tgh-apil/airway_intubation_model/mandible_and_tongue_casting.md

## Mandible and tongue

The following instructions detail the process for casting the mandible and tongue, including both the healthy and pathological (tumor at base of tongue) variants. While the two variants require separate molds and different silicones, the steps for casting are the same.

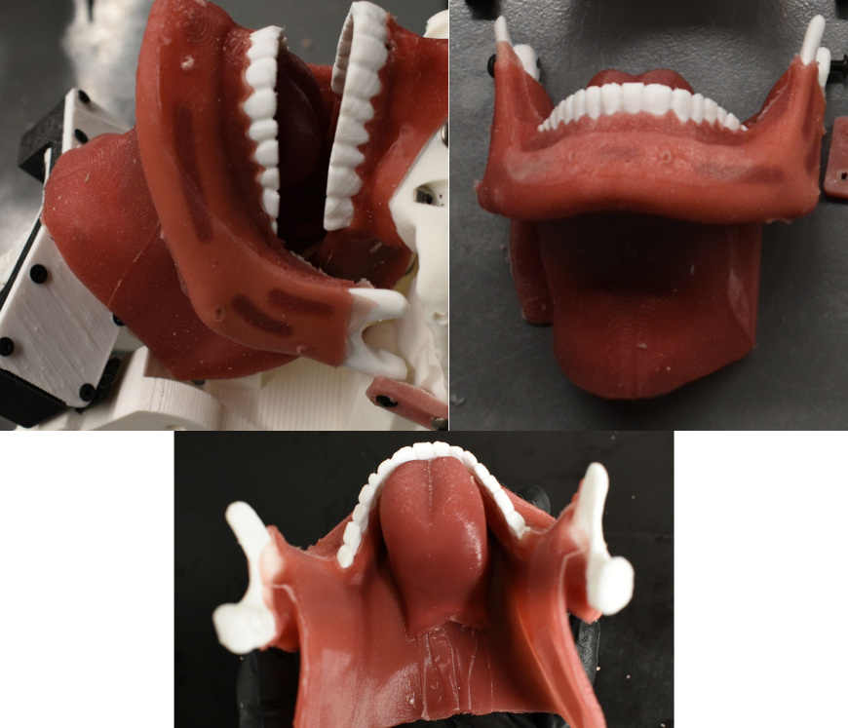
[picture p11: images/mandible_casting/0_mandible.png]


### Materials & equipment
#### Hardware
- 4 x 35mm M4 screws
- 2 x 25mm M4 screws
- 4 x 20mm M4 screws
- 4 x 18mm M4 screws
- 2 x 18mm M3 screws
- 6 x 14mm M3 screws
- Power drill or screwdriver

#### Printing
- Hard plastic filament (PLA, etc.)
- Fused Deposition Modelling 3D printer

#### Casting
- Two-part Platinum Cure Silicone Rubber
  - **Healthy anatomy:** Ecoflex 00-20: Available from [Smooth-On](https://www.smooth-on.com/products/ecoflex-00-20/)
  - **Pathological anatomy (tumor):** Ecoflex 00-30: Available from [Smooth-On](https://www.smooth-on.com/products/ecoflex-00-30/)
- Silc Pig silicone pigments in blood: Available from [Smooth-On](https://www.smooth-on.com/products/silc-pig/)
- Mold release agent: Available from [Smooth-On](https://www.smooth-on.com/product-line/universal-mold-release/)
- Hot glue gun
- Mesh stretch fabric (nylon, polyester, etc.)

#### Components
Anatomy/casting components:
- mandible ([mandible.stl](https://github.com/tgh-apil/airway_intubation_model/blob/main/stl_files/mandible_and_tongue_casting/mandible.stl))
- epiglottis casting plate ([epiglottis_plate.stl](https://github.com/tgh-apil/airway_intubation_model/blob/main/stl_files/mandible_and_tongue_casting/epiglottis_plate.stl))

Healthy mold components:
- back ([mandible_mold_back.stl](https://github.com/tgh-apil/airway_intubation_model/blob/main/stl_files/mandible_and_tongue_casting/healthy_anatomy_mold/mandible_mold_back.stl))
- bottom ([mandible_mold_bottom.stl](https://github.com/tgh-apil/airway_intubation_model/blob/main/stl_files/mandible_and_tongue_casting/healthy_anatomy_mold/mandible_mold_bottom.stl))
- front left ([mandible_mold_front_L.stl](https://github.com/tgh-apil/airway_intubation_model/blob/main/stl_files/mandible_and_tongue_casting/healthy_anatomy_mold/mandible_mold_front_L.stl))
- front right ([mandible_mold_front_R.stl](https://github.com/tgh-apil/airway_intubation_model/blob/main/stl_files/mandible_and_tongue_casting/healthy_anatomy_mold/mandible_mold_front_R.stl))
- side left ([mandible_mold_side_L.stl](https://github.com/tgh-apil/airway_intubation_model/blob/main/stl_files/mandible_and_tongue_casting/healthy_anatomy_mold/mandible_mold_side_L.stl))
- side right ([mandible_mold_side_R.stl](https://github.com/tgh-apil/airway_intubation_model/blob/main/stl_files/mandible_and_tongue_casting/healthy_anatomy_mold/mandible_mold_side_R.stl))
- top ([mandible_mold_top.stl](https://github.com/tgh-apil/airway_intubation_model/blob/main/stl_files/mandible_and_tongue_casting/healthy_anatomy_mold/mandible_mold_top.stl))

Pathological mold components:
- back ([mandible_mold_back_tumor.stl](https://github.com/tgh-apil/airway_intubation_model/blob/main/stl_files/mandible_and_tongue_casting/pathological_anatomy_mold/mandible_mold_back_tumor.stl))
- bottom ([mandible_mold_bottom_tumor.stl](https://github.com/tgh-apil/airway_intubation_model/blob/main/stl_files/mandible_and_tongue_casting/pathological_anatomy_mold/mandible_mold_bottom_tumor.stl))
- front left ([mandible_mold_front_L_tumor.stl](https://github.com/tgh-apil/airway_intubation_model/blob/main/stl_files/mandible_and_tongue_casting/pathological_anatomy_mold/mandible_mold_front_L_tumor.stl))
- front right ([mandible_mold_front_R_tumor.stl](https://github.com/tgh-apil/airway_intubation_model/blob/main/stl_files/mandible_and_tongue_casting/pathological_anatomy_mold/mandible_mold_front_R_tumor.stl))
- side left ([mandible_mold_side_L_tumor.stl](https://github.com/tgh-apil/airway_intubation_model/blob/main/stl_files/mandible_and_tongue_casting/pathological_anatomy_mold/mandible_mold_side_L_tumor.stl))
- side right ([mandible_mold_side_R_tumor.stl](https://github.com/tgh-apil/airway_intubation_model/blob/main/stl_files/mandible_and_tongue_casting/pathological_anatomy_mold/mandible_mold_side_R_tumor.stl))
- top ([mandible_mold_top_tumor.stl](https://github.com/tgh-apil/airway_intubation_model/blob/main/stl_files/mandible_and_tongue_casting/pathological_anatomy_mold/mandible_mold_top_tumor.stl))

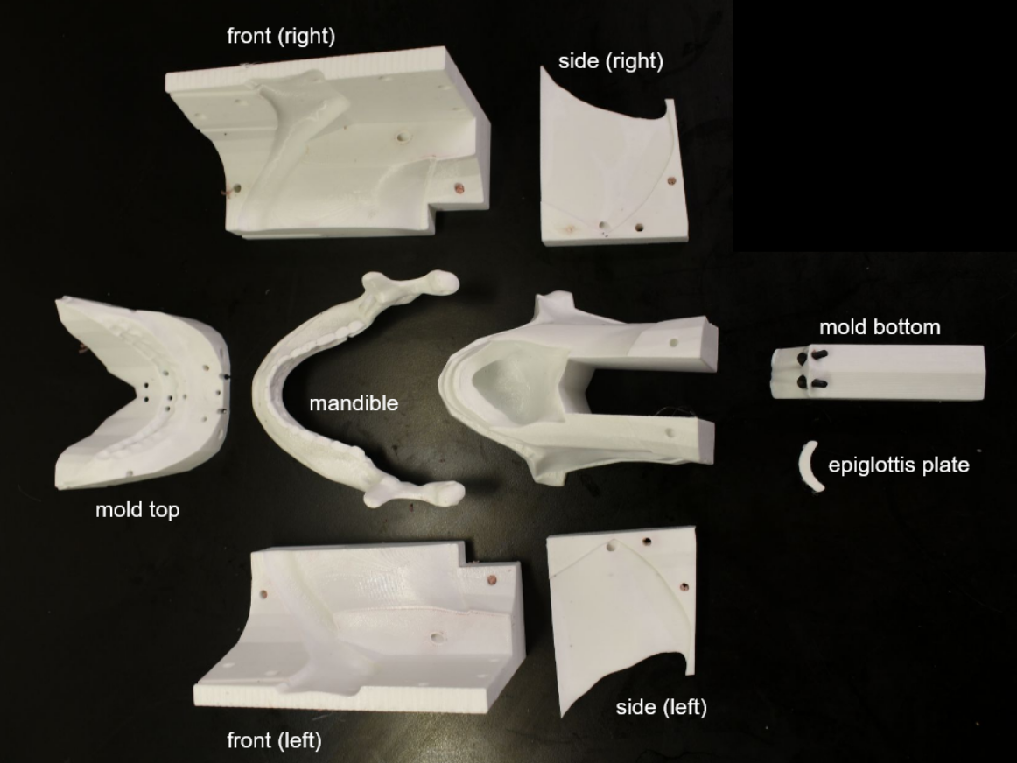
[picture p12: images/mandible_casting/1_mandible.png]


### Instructions
1. Print the components listed above for the desired variant (the healthy variant is shown in the images below).
2. Apply mold release agent to the mold components. Do not apply it to the mandible or epiglottis casting plate, as the silicone is not intended to be removed from these components.
3. Optionally, cut out a small rectangle of mesh fabric large enough to cover the epiglottis plate—about 2cm x 4cm. Overlay it on top of the plate and use a marker to mark the location of the holes for the screws, then make small cuts in the fabric at these locations to ease the screw insertion process later. (Note: The mesh is not strictly necessary, but improves the longevity of the cast piece by preventing the epiglottis plate from tearing out of the silicone.)
4. Per the image below, align the epiglottis plate about 0.5cm above the bottom mold component so that the holes in the plate are aligned with those of the bottom mold component, and the concave side of the plate faces the convex side of the bottom mold component. Use two 14mm M3 screws to attach the two while maintaining the ~0.5cm gap. If using the mesh fabric, pass the screws through it as well and insert it between the epiglottis plate and the mold component.

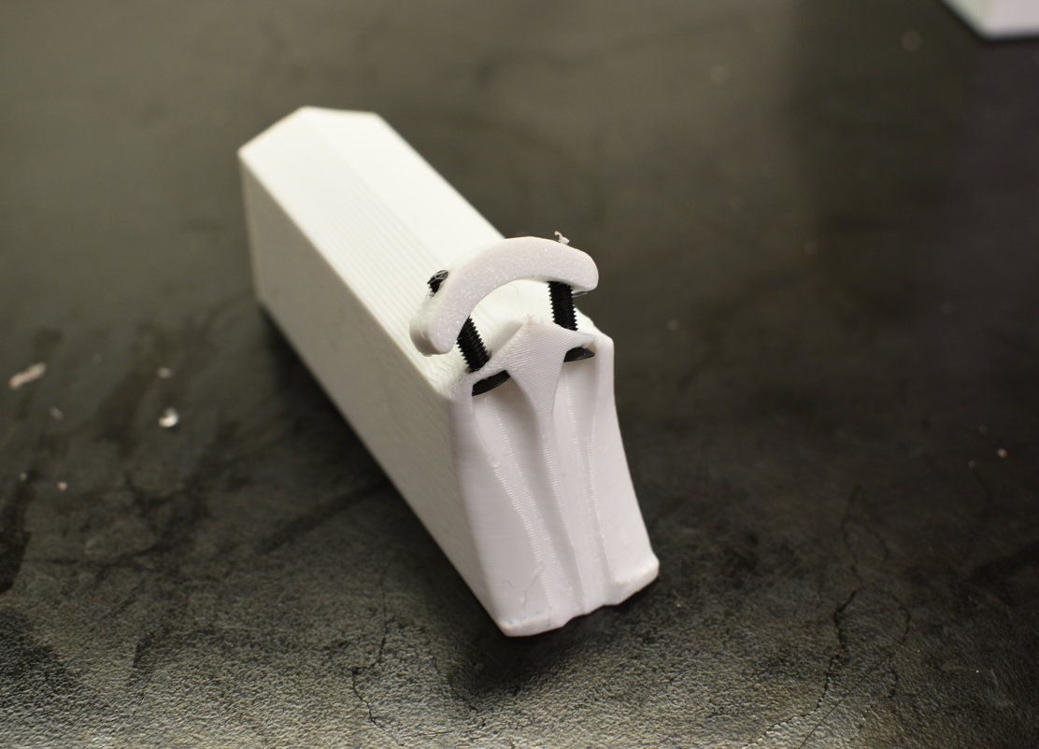
[picture p13: images/mandible_casting/2_mandible.png]


5. Assemble the rest of the mold.
    1. Align the body and ramus of the mandible with the groove in one side of the outer mold and attach the two with two 14mm M3 screws. Do the same with the other side of the outer mold.

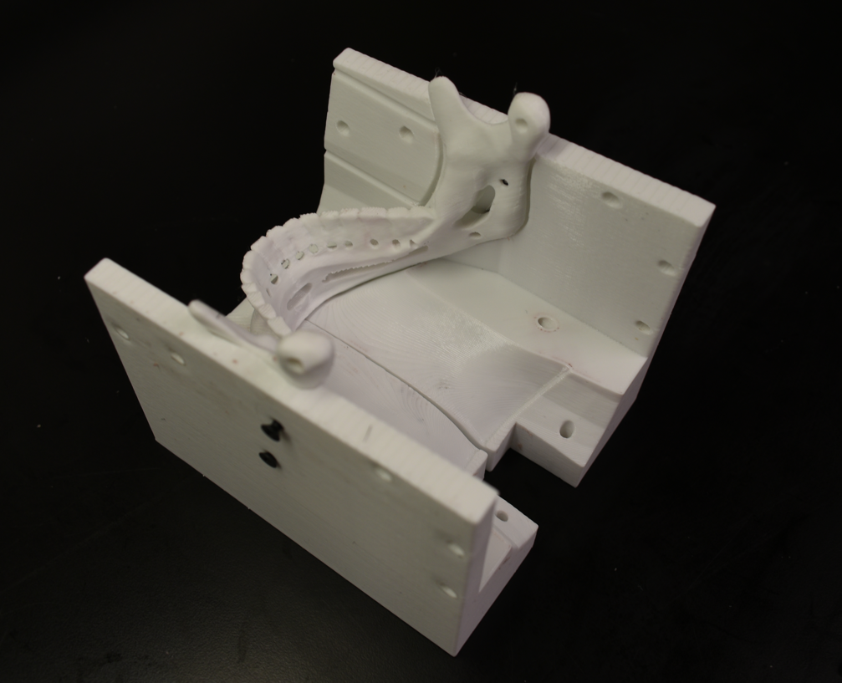
[picture p14: images/mandible_casting/3_mandible.png]
       
    2. Attach the two side mold components with one 18mm M4 screw each in the following hole (see image). The side components will later also be attached to the back mold component with two 35mm M4s.

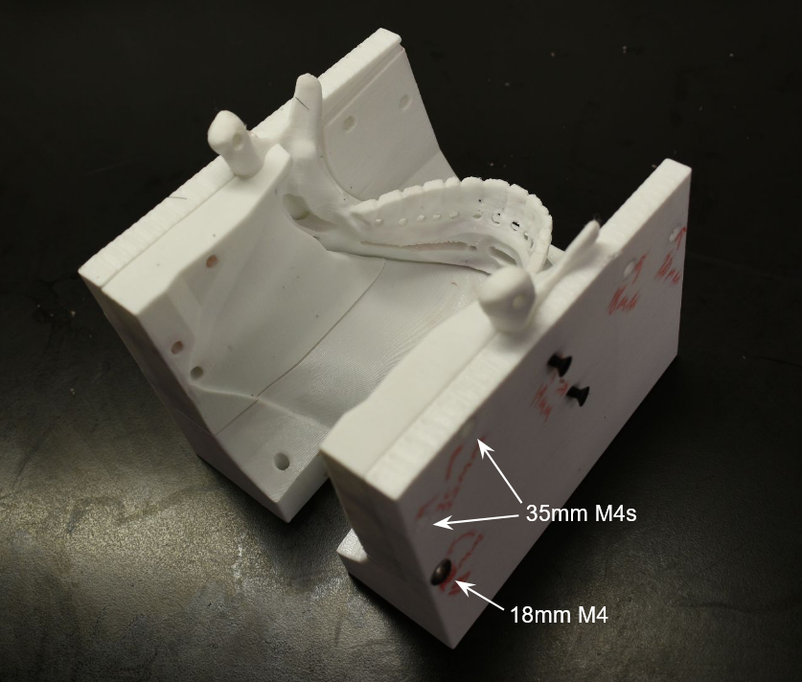
[picture p15: images/mandible_casting/4_mandible.png]
       
    3. Slide the bottom component (with epiglottis plate attached) into the slot in the back component so the curved portions at the fronts of the components lie flush.

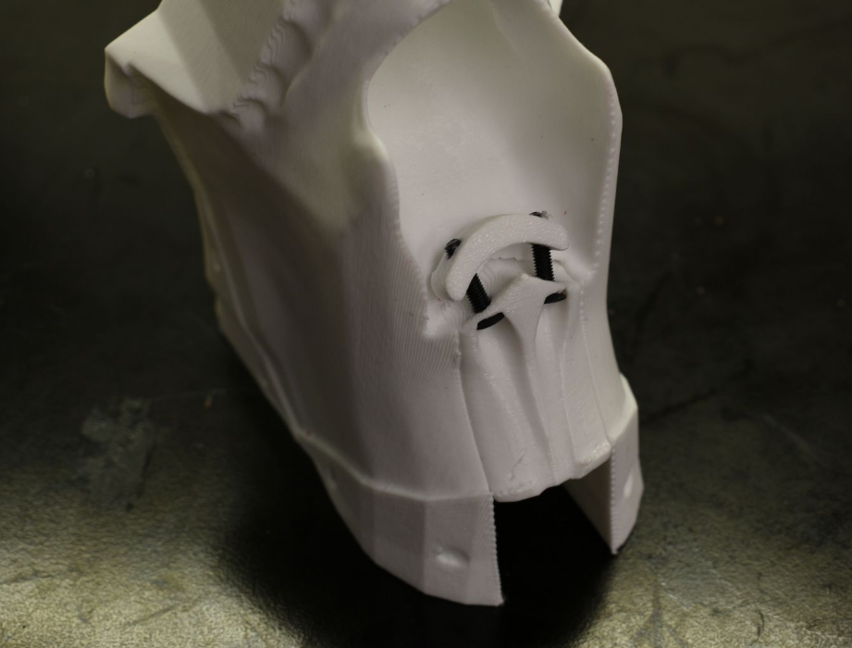
[picture p16: images/mandible_casting/5_mandible.png]
       
    4. Attach the back component to the rest of the mold with four 35mm M4 screws (the ones that also pass through the side mold components), and two 18mm M4 screws.
    5. Attach the top mold component with two 25mm M4 screws and four 20mm M4 screws, then with two 18mm M3 screws to attach it to the mandible inside.

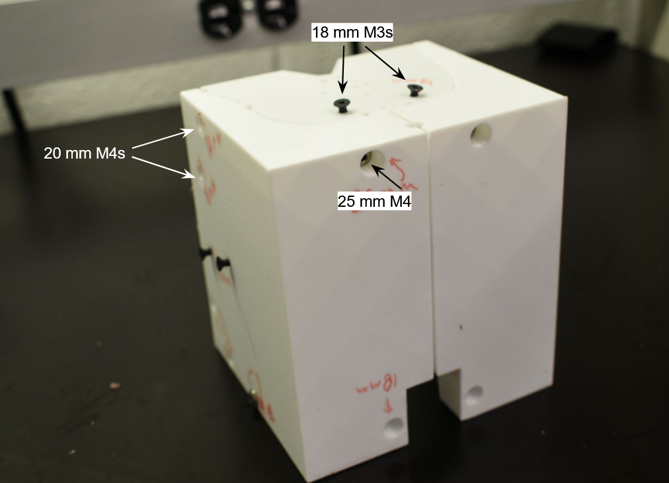
[picture p17: images/mandible_casting/6_mandible.png]


6. Use a hot glue gun to seal the seams of the mold to prevent silicone from leaking during the casting process. Small pieces of paper towel may be crumpled into the deeper screw holes first to make the removal of the glue easier later on.

7. Mix 200 mL of Ecoflex 00-20 for the healthy variant, or 200 mL of Ecoflex 00-30 for the pathological variant, dyed with Silc Pig pigment in the colour Blood. Inject into mold using the largest vent hole.

8. Once cured, remove the hot glue and unscrew the mold components. Remove the mold components, cutting the vent hole paths as you go, until you are left with the back and bottom components. Before removing the silicone from these, you will need to unscrew the two 14mm M3s attached to the epiglottis plate which has now been embedded in the silicone. 

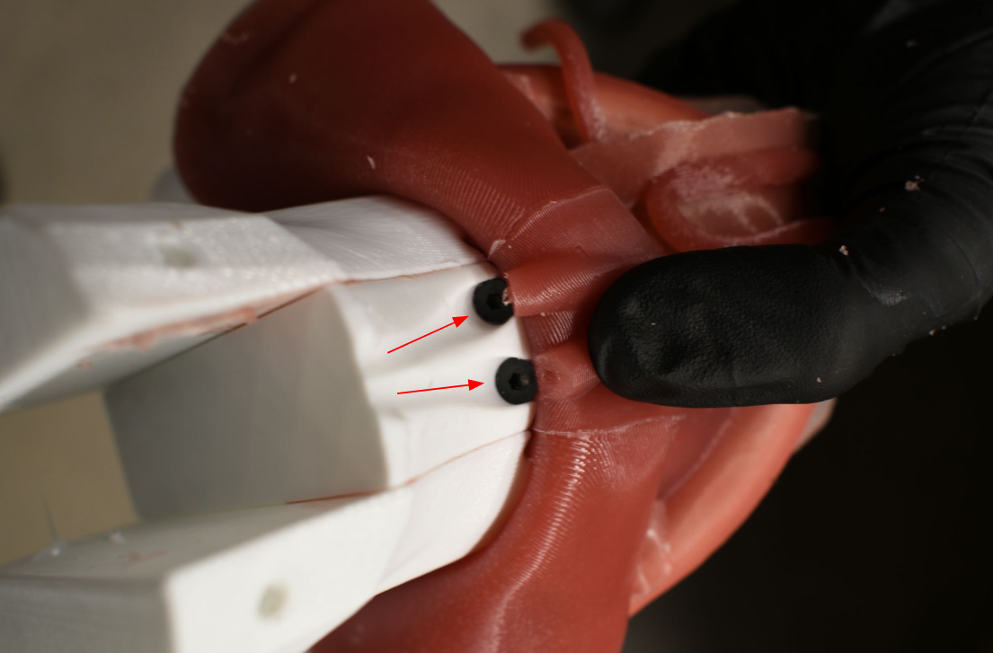
[picture p18: images/mandible_casting/7_mandible.png]


9. Once the silicone has been fully removed from the mold, trim any flashing and cut away the excess silicone on the teeth to reveal them.
