tgh-apil/airway_intubation_model/pharynx_casting.md

## Pharynx

The following instructions detail the process for casting the silicone component comprising the roof of mouth and back of throat.

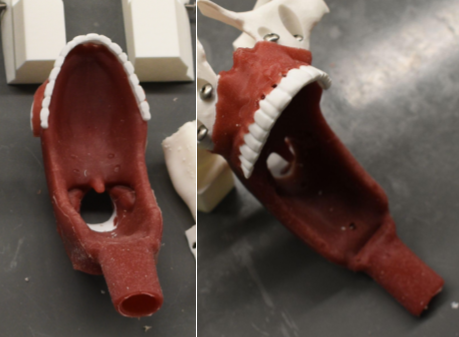
[picture p22: images/pharynx_casting/pharynx_cast.png]


### Materials & equipment
#### Hardware
- 46 x 10mm M4 screws
- 2 x 18mm M4 screws
- 2 x 20mm M4 screws
- Power drill or screwdriver

#### Printing
- Hard plastic filament (PLA, etc.)
- Fused Deposition Modelling 3D printer

#### Casting
- Two-part Platinum Cure Silicone Rubber
  - Ecoflex 00-30: Available from [Smooth-On](https://www.smooth-on.com/products/ecoflex-00-30/)
- Silc Pig silicone pigments in blood: Available from [Smooth-On](https://www.smooth-on.com/products/silc-pig/)
- Mold release agent: Available from [Smooth-On](https://www.smooth-on.com/product-line/universal-mold-release/)
- Hot glue gun

#### Components
Anatomy:
- pharynx: ([upper_jaw_pharynx.stl](https://github.com/tgh-apil/airway_intubation_model/blob/main/stl_files/pharynx_casting/upper_jaw_pharynx.stl))

Mold components:
- back lower left ([pharynx_mold_back_lower_L.stl](https://github.com/tgh-apil/airway_intubation_model/blob/main/stl_files/pharynx_casting/pharynx_mold/pharynx_mold_back_lower_L.stl))
- back lower right ([pharynx_mold_back_lower_R.stl](https://github.com/tgh-apil/airway_intubation_model/blob/main/stl_files/pharynx_casting/pharynx_mold/pharynx_mold_back_lower_R.stl))
- back upper left part A ([pharynx_mold_back_upper_La.stl](https://github.com/tgh-apil/airway_intubation_model/blob/main/stl_files/pharynx_casting/pharynx_mold/pharynx_mold_back_upper_La.stl))
- back upper left part B ([pharynx_mold_back_upper_Lb.stl](https://github.com/tgh-apil/airway_intubation_model/blob/main/stl_files/pharynx_casting/pharynx_mold/pharynx_mold_back_upper_Lb.stl))
- back upper right part A ([pharynx_mold_back_upper_Ra.stl](https://github.com/tgh-apil/airway_intubation_model/blob/main/stl_files/pharynx_casting/pharynx_mold/pharynx_mold_back_upper_Ra.stl))
- back upper right part B ([pharynx_mold_back_upper_Rb.stl](https://github.com/tgh-apil/airway_intubation_model/blob/main/stl_files/pharynx_casting/pharynx_mold/pharynx_mold_back_upper_Rb.stl))
- esophagus inner ([pharynx_mold_esophagus_inner.stl](https://github.com/tgh-apil/airway_intubation_model/blob/main/stl_files/pharynx_casting/pharynx_mold/pharynx_mold_esophagus_inner.stl))
- esophagus left ([pharynx_mold_esophagus_L.stl](https://github.com/tgh-apil/airway_intubation_model/blob/main/stl_files/pharynx_casting/pharynx_mold/pharynx_mold_esophagus_L.stl))
- esophagus right ([pharynx_mold_esophagus_R.stl](https://github.com/tgh-apil/airway_intubation_model/blob/main/stl_files/pharynx_casting/pharynx_mold/pharynx_mold_esophagus_R.stl))
- lower front ([pharynx_mold_front_lower.stl](https://github.com/tgh-apil/airway_intubation_model/blob/main/stl_files/pharynx_casting/pharynx_mold/pharynx_mold_front_lower.stl))
- upper front ([pharynx_mold_front_upper.stl](https://github.com/tgh-apil/airway_intubation_model/blob/main/stl_files/pharynx_casting/pharynx_mold/pharynx_mold_front_upper.stl))
- connector plates: ([\pharynx_casting\pharynx_mold\connector plates](https://github.com/tgh-apil/airway_intubation_model/tree/main/stl_files/pharynx_casting/pharynx_mold/connector%20plates))

### Instructions
1. Print the components listed above in hard plastic filament.
2. Apply mold release agent to the mold components. Do not apply it to the pharynx, as the silicone is not intended to be removed from this component. It is also not necessary to apply it to the connector plates as they do not come into direct contact with the silicone.
3. Assemble the mold. (It is recommended to begin with one side; these instructions begin with the left for the sake of clarity, but beginning with the right is equally feasible.)
    1. Slot the back lower left component into the pharynx and attach together with an 18mm M4 screw.

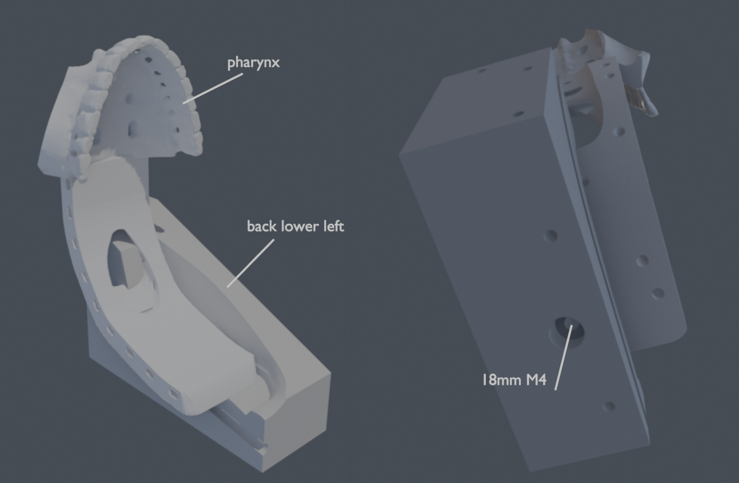
[picture p23: images/pharynx_casting/1_pharynx.png]
       
    2. Slot the back upper left part A component into the pharynx and attach together with a 20mm M4 screw.

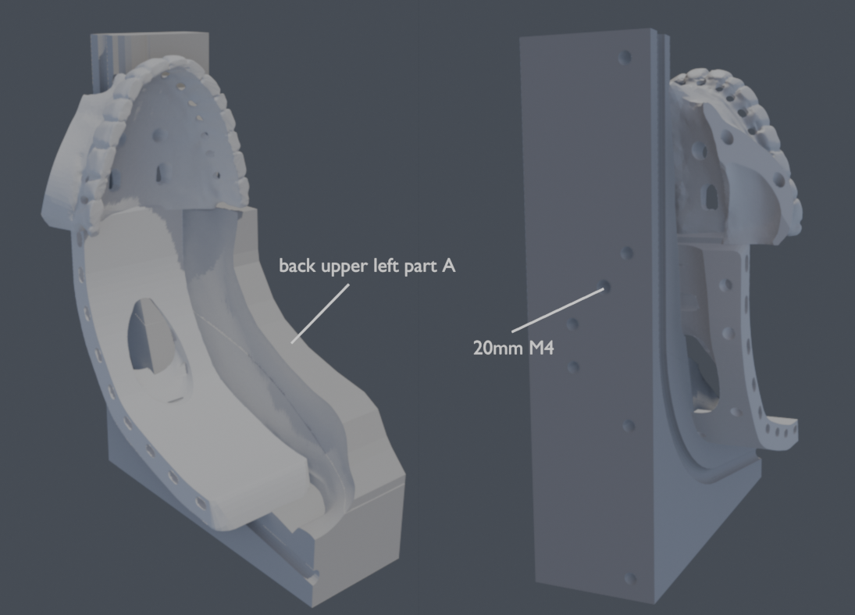
[picture p24: images/pharynx_casting/2_pharynx.png]
       
    3. Secure the back left components with the left connector plate and four 10mm M4s.

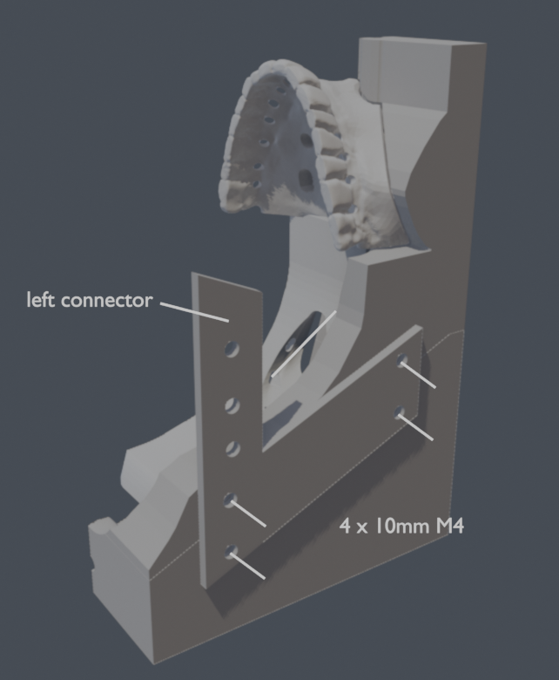
[picture p25: images/pharynx_casting/3_pharynx.png]
       
    4. Repeat the above steps with the right side of the back lower and upper components, and the right connector plate.
    5. Insert the upper front component, then the lower front component. Attach to mold with the left and right connector plates and six 10mm M4s.

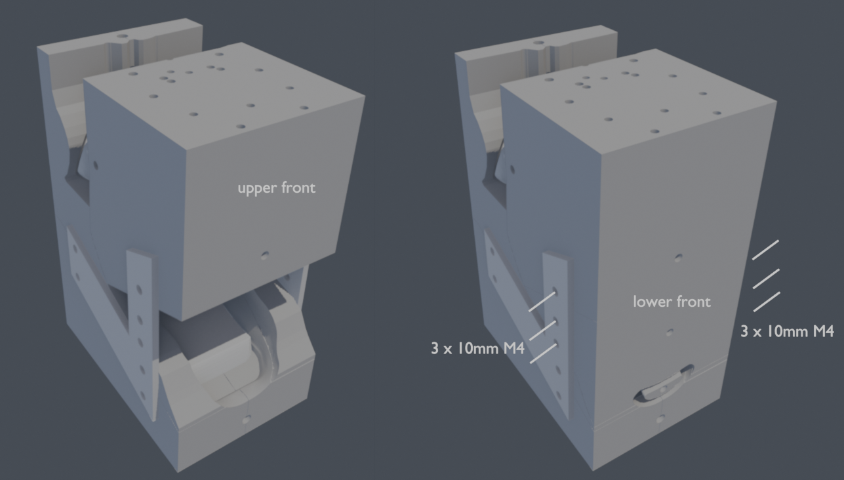
[picture p26: images/pharynx_casting/5_pharynx.png]
       
    6. Insert the back upper left and right part B components.
    7. Assemble the three esophagus components (left, right, and inner) and attach to the main mold with the front and back lower connector plates and sixteen 10mm M4s.
       
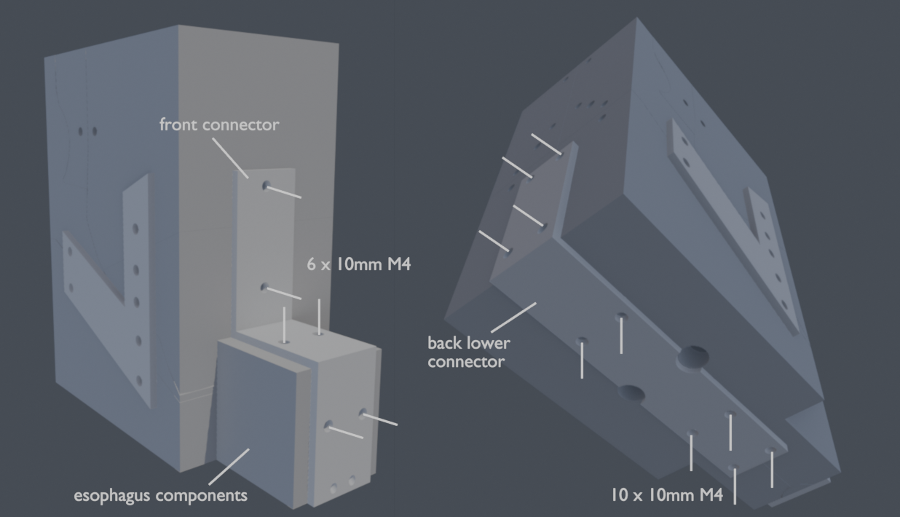
[picture p27: images/pharynx_casting/7_pharynx.png]
       
    8. Secure the remainder of the mold with the remaining connector plates (back, back upper, and top) and sixteen 10mm M4s.

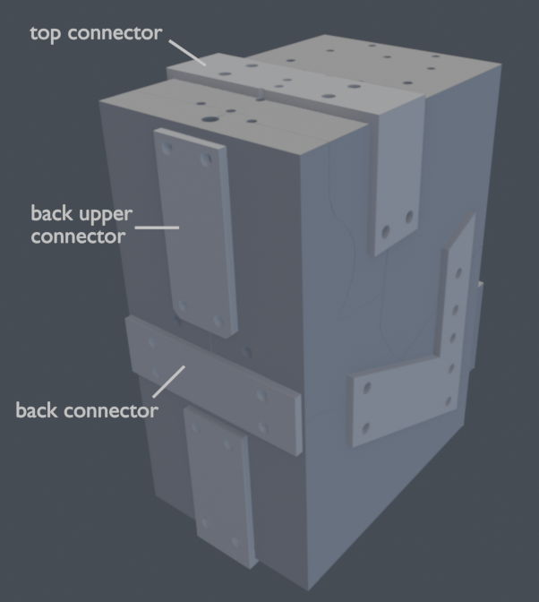
[picture p28: images/pharynx_casting/8_pharynx.png]
       
4. Use a hot glue gun to seal the seams of the mold to prevent silicone from leaking during the casting process.
5. Mix 300 mL of Ecoflex 00-30, dyed with Silc Pig blood pigment. Inject into mold using the largest vent hole.
6. Once cured, disassemble the mold in reverse order of assembly. Trim any flashing and cut out the teeth and airway.
