tgh-apil/airway_intubation_model/images/mandible_casting/8_mandible.png

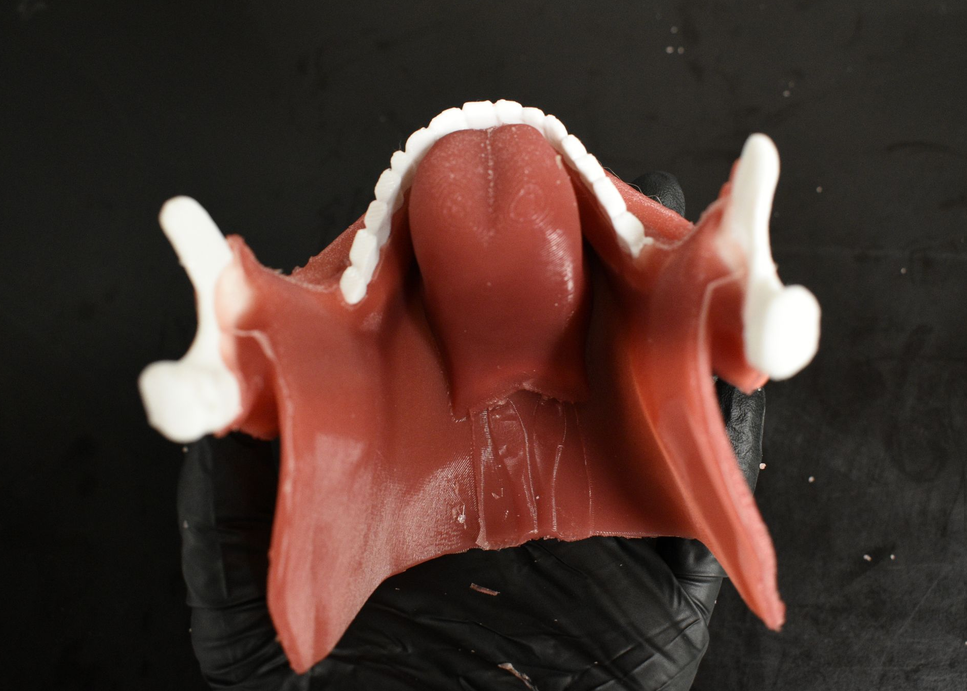
images/mandible_casting/8_mandible.png
