tgh-apil/airway_intubation_model/images/pharynx_casting/4_pharynx.png

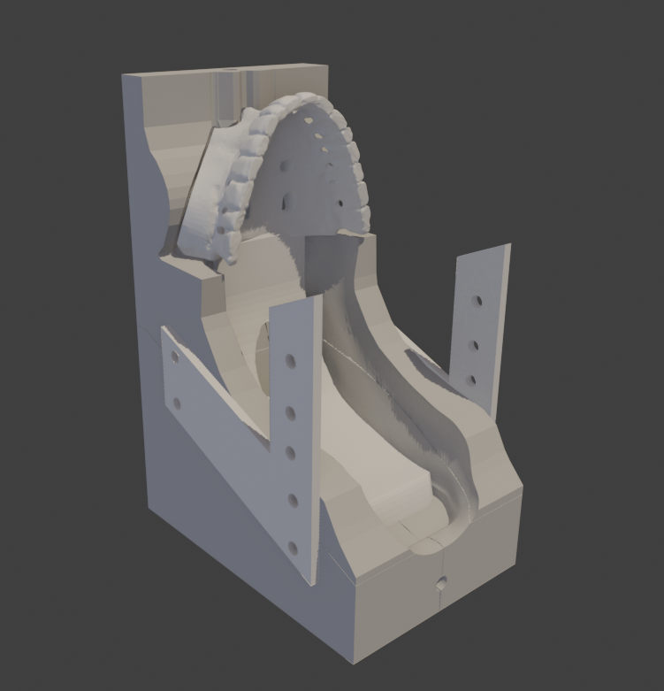
images/pharynx_casting/4_pharynx.png
