tgh-apil/airway_intubation_model/images/pharynx_casting/6_pharynx.png

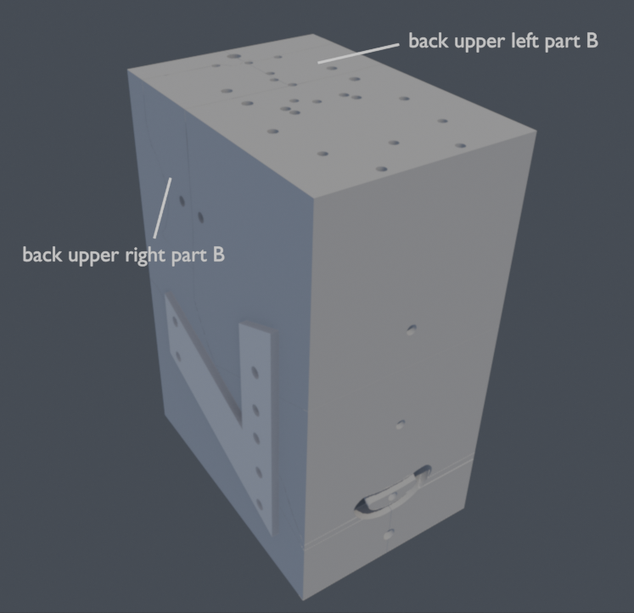
images/pharynx_casting/6_pharynx.png
