tgh-apil/airway_intubation_model/images/model_assembly_instructions/0_intubation_model_components.png

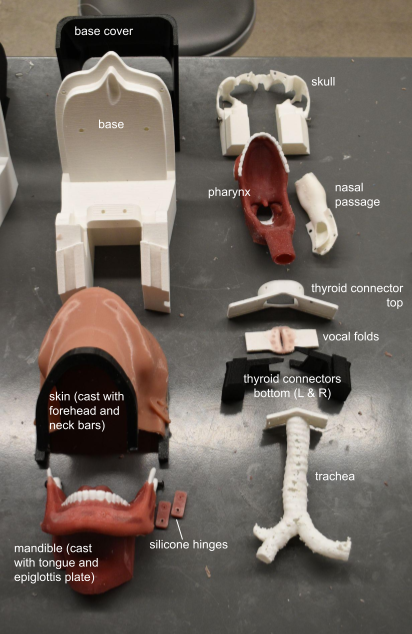
images/model_assembly_instructions/0_intubation_model_components.png
