tgh-apil/airway_intubation_model/stl_files/base/skull.stl

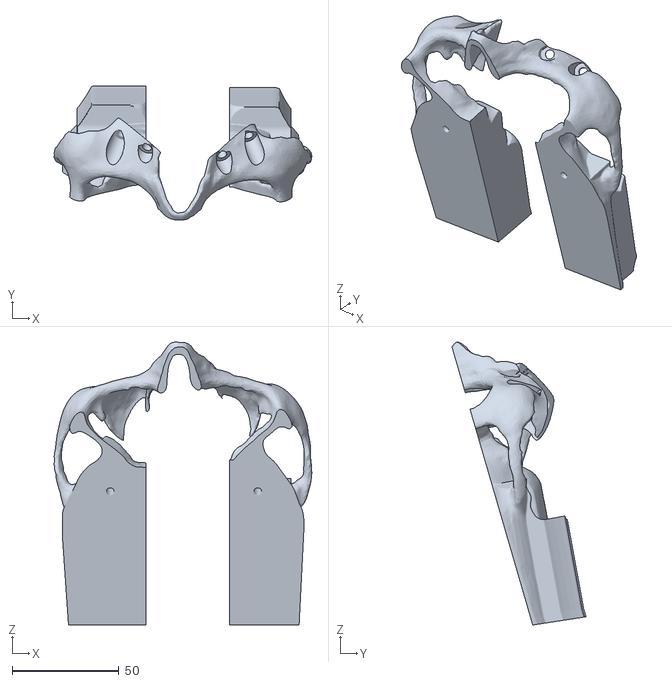
[picture p37: CAD file, 2026-10-07]
stl_files/base/skull.stl
120.5 x 62.7 x 132.3
