tgh-apil/airway_intubation_model/stl_files/mandible_and_tongue_casting/healthy_anatomy_mold/mandible_mold_bottom.stl

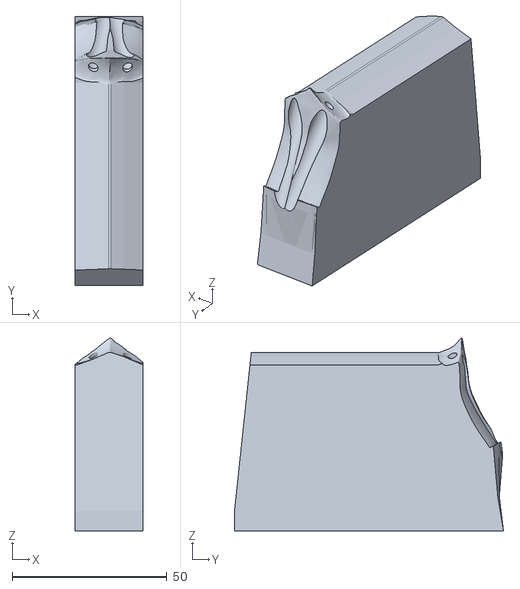
[picture p38: CAD file, 2026-10-06]
stl_files/mandible_and_tongue_casting/healthy_anatomy_mold/mandible_mold_bottom.stl
22.1 x 87.0 x 62.3
