tgh-apil/airway_intubation_model/stl_files/mandible_and_tongue_casting/mandible.stl

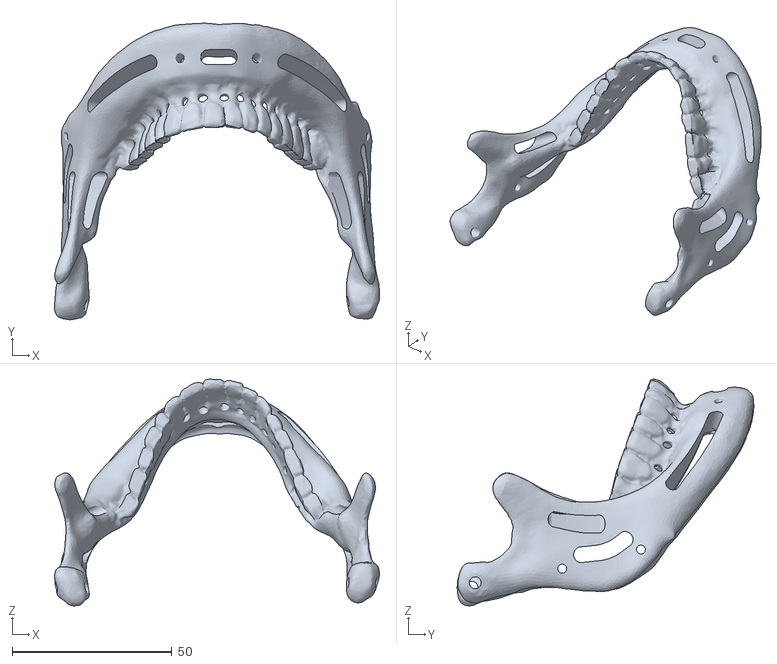
[picture p39: CAD file, 2026-10-06]
stl_files/mandible_and_tongue_casting/mandible.stl
101.6 x 92.7 x 70.9
