tgh-apil/airway_intubation_model/stl_files/mandible_and_tongue_casting/pathological_anatomy_mold/mandible_mold_front_L_tumor.stl

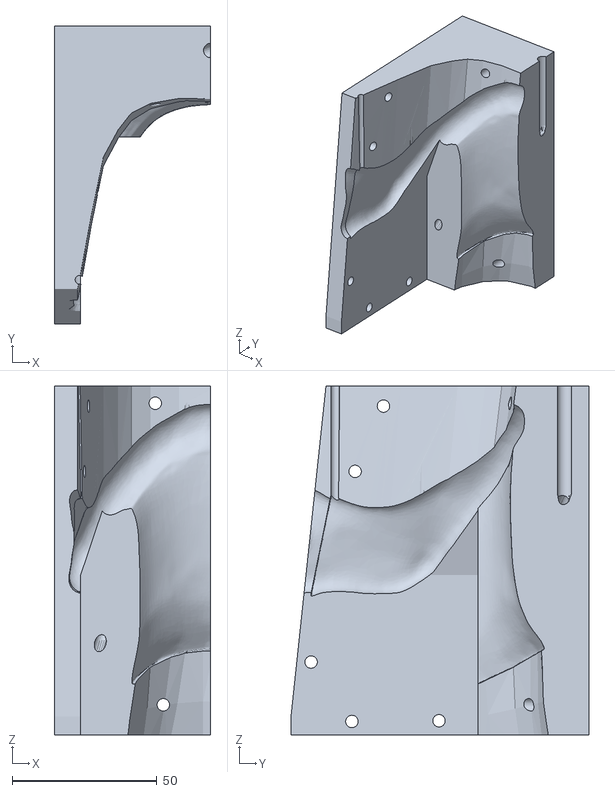
[picture p40: CAD file, 2026-10-06]
stl_files/mandible_and_tongue_casting/pathological_anatomy_mold/mandible_mold_front_L_tumor.stl
54.1 x 103.0 x 120.6
