tgh-apil/airway_intubation_model/stl_files/nasal_passage.stl

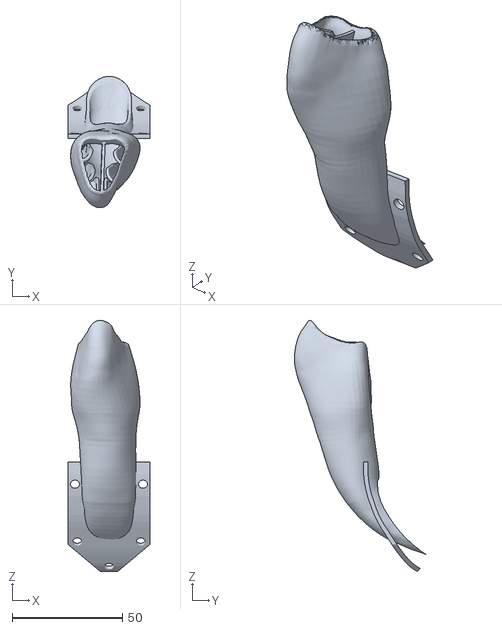
[picture p41: CAD file, 2026-10-07]
stl_files/nasal_passage.stl
37.1 x 59.5 x 113.7
