tgh-apil/airway_intubation_model/stl_files/pharynx_casting/pharynx_mold/connector plates/pharynx_mold_connector_top.stl

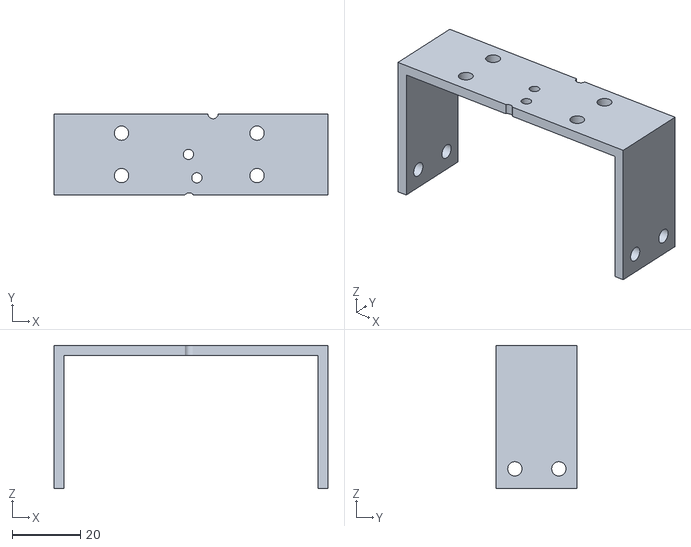
[picture p42: CAD file, 2026-09-28]
stl_files/pharynx_casting/pharynx_mold/connector plates/pharynx_mold_connector_top.stl
80.3 x 23.6 x 42.0
