tgh-apil/airway_intubation_model/stl_files/pharynx_casting/pharynx_mold/pharynx_mold_back_upper_Lb.stl

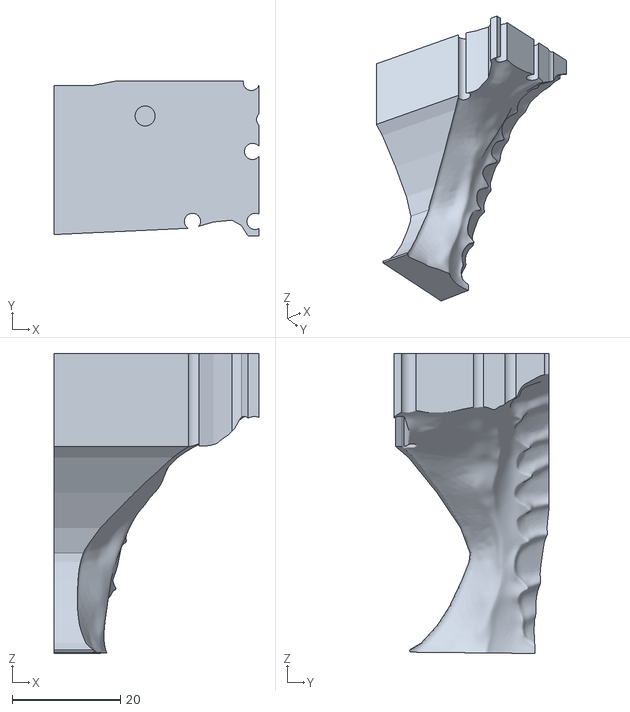
[picture p43: CAD file, 2026-09-28]
stl_files/pharynx_casting/pharynx_mold/pharynx_mold_back_upper_Lb.stl
37.8 x 28.7 x 55.4
