tgh-apil/airway_intubation_model/stl_files/pharynx_casting/upper_jaw_pharynx.stl

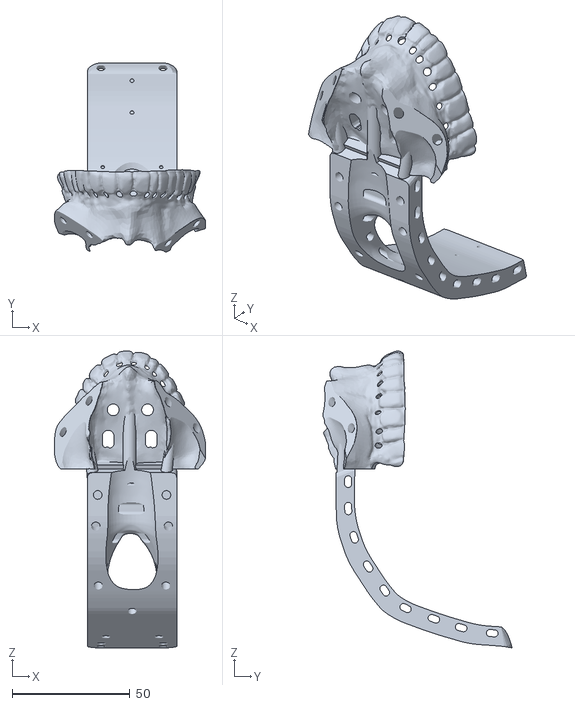
[picture p44: CAD file, 2026-09-28]
stl_files/pharynx_casting/upper_jaw_pharynx.stl
64.4 x 80.5 x 126.2
