tgh-apil/airway_intubation_model/stl_files/skin_casting/skin_mold/skin_mold_bottom.stl

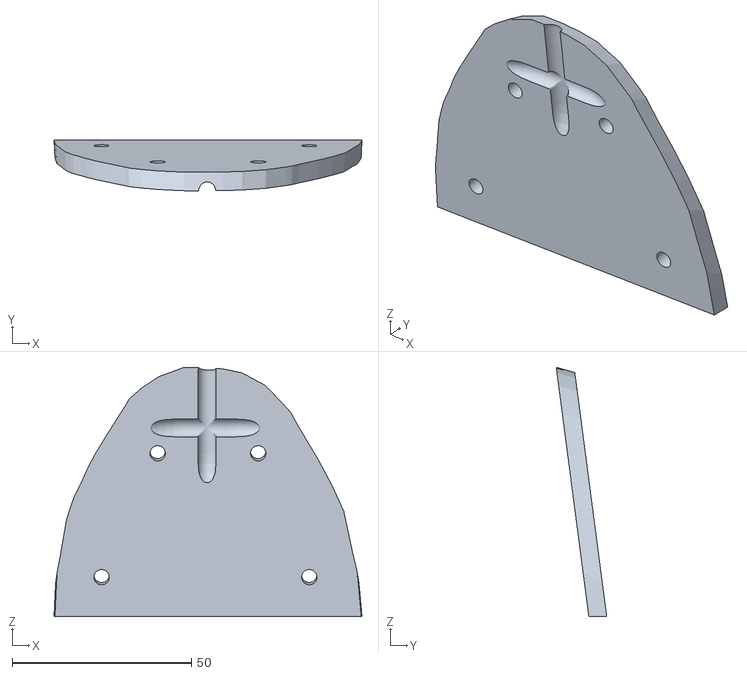
[picture p45: CAD file, 2026-09-29]
stl_files/skin_casting/skin_mold/skin_mold_bottom.stl
86.0 x 14.1 x 69.6
