tgh-apil/airway_intubation_model/stl_files/skin_casting/skin_neck_bar.stl

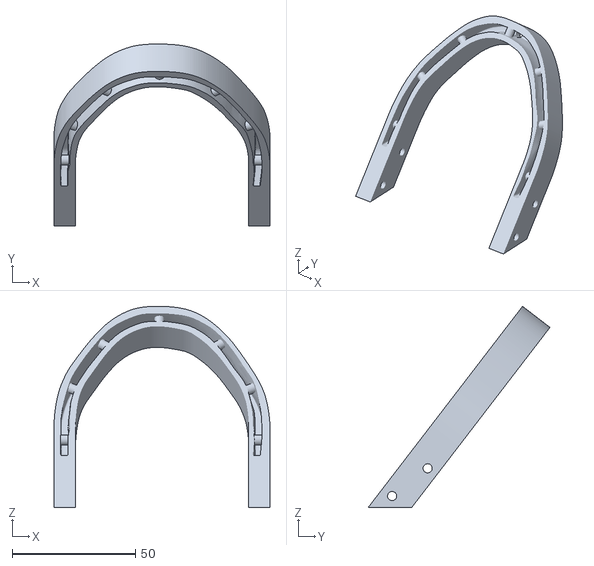
[picture p46: CAD file, 2026-09-29]
stl_files/skin_casting/skin_neck_bar.stl
87.5 x 73.7 x 81.5
