tgh-apil/airway_intubation_model/stl_files/thyroid_cartilage_and_connector/thyroid_connector_bottom_L.stl

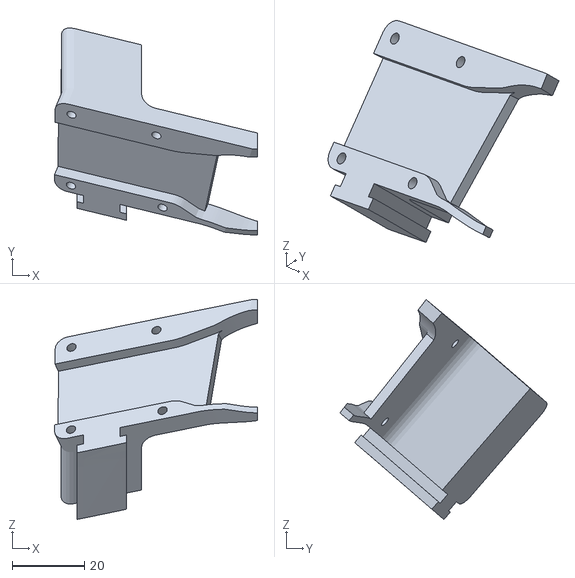
[picture p47: CAD file, 2026-10-07]
stl_files/thyroid_cartilage_and_connector/thyroid_connector_bottom_L.stl
56.0 x 57.1 x 60.7
