tgh-apil/airway_intubation_model/stl_files/trachea/pathological/trach_tumor_holder_2.stl

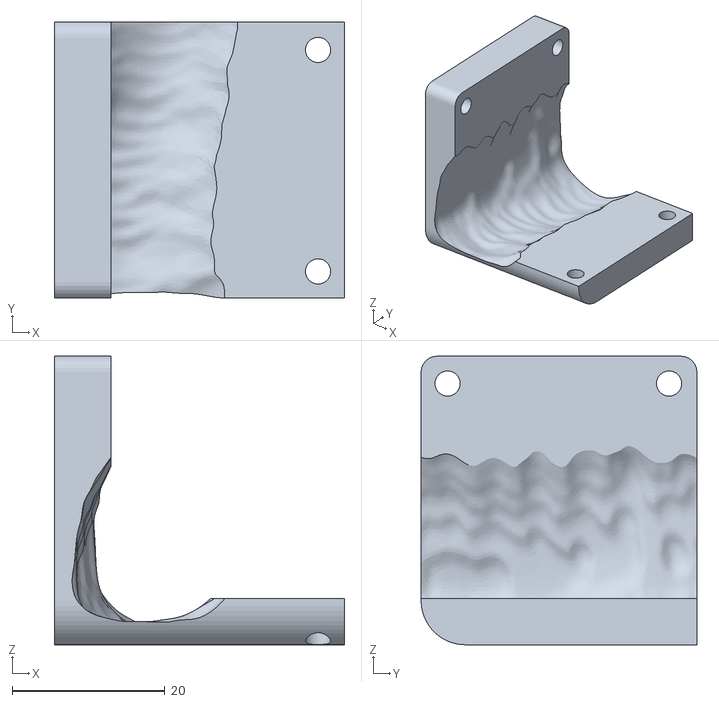
[picture p48: CAD file, 2026-09-21]
stl_files/trachea/pathological/trach_tumor_holder_2.stl
38.0 x 36.2 x 37.8
