tgh-apil/airway_intubation_model/stl_files/trachea/trachea_healthy_v3.stl

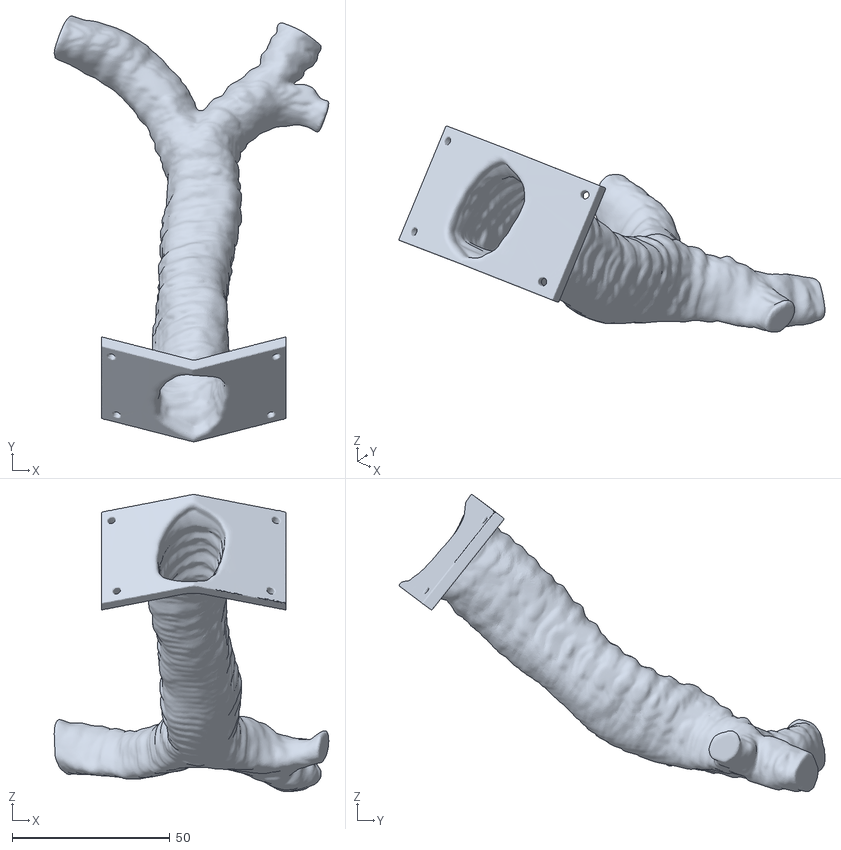
[picture p49: CAD file, 2026-09-21]
stl_files/trachea/trachea_healthy_v3.stl
86.9 x 134.8 x 94.2
