tgh-apil/airway_intubation_model/stl_files/vocal_folds/vocal_fold_wing_R.stl

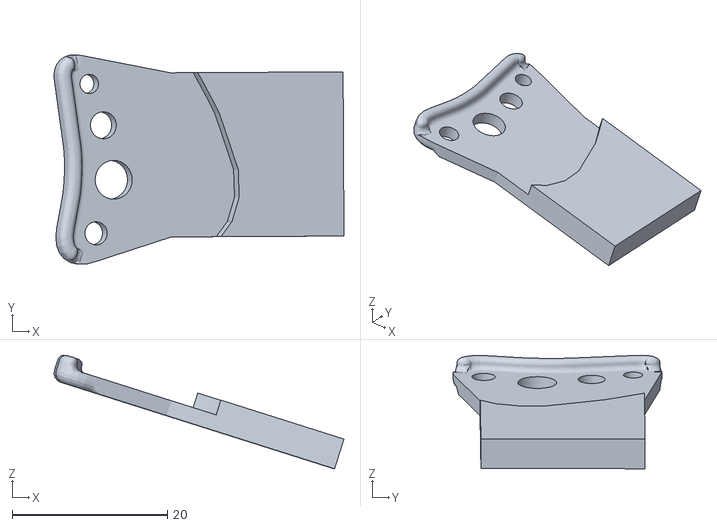
[picture p51: CAD file, 2026-10-12]
stl_files/vocal_folds/vocal_fold_wing_R.stl
37.3 x 27.0 x 14.6
