tgh-apil/airway_intubation_model/stl_files/base/intubation_base.stl

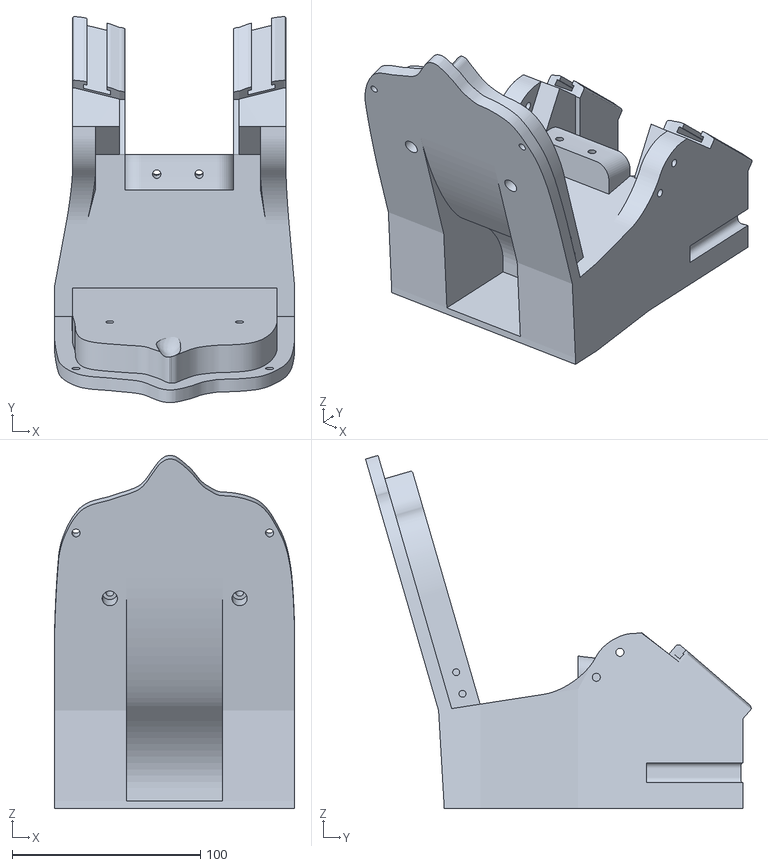
[picture p52: CAD file, 2026-10-07]
stl_files/base/intubation_base.stl
127.7 x 205.0 x 187.6
