tgh-apil/airway_intubation_model/stl_files/mandible_and_tongue_casting/epiglottis_plate.stl

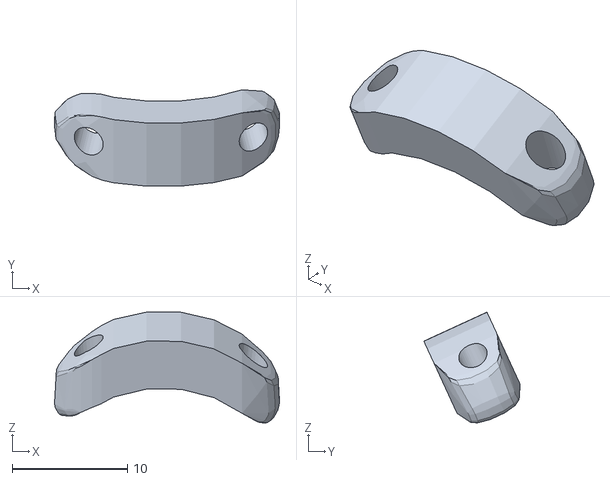
[picture p53: CAD file, 2026-10-06]
stl_files/mandible_and_tongue_casting/epiglottis_plate.stl
19.5 x 8.37 x 9.62
