tgh-apil/airway_intubation_model/stl_files/mandible_and_tongue_casting/healthy_anatomy_mold/mandible_mold_side_L.stl

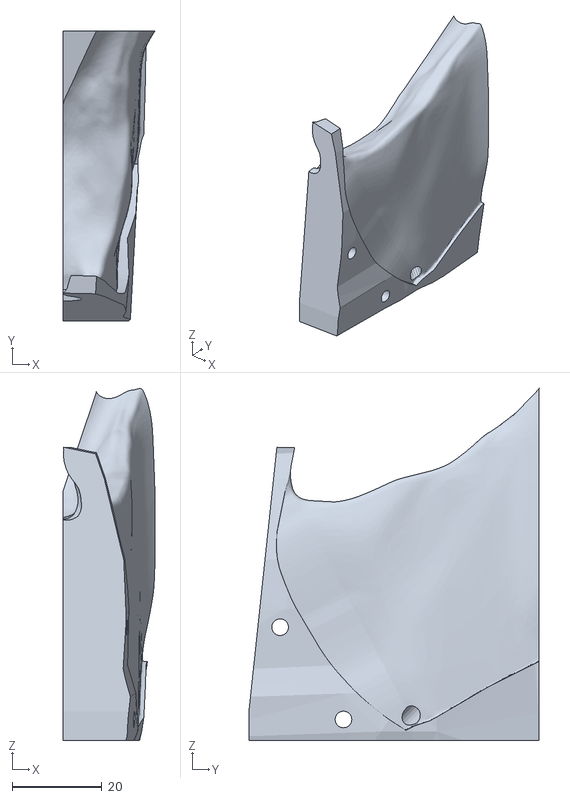
[picture p54: CAD file, 2026-10-06]
stl_files/mandible_and_tongue_casting/healthy_anatomy_mold/mandible_mold_side_L.stl
20.5 x 64.6 x 78.3
