tgh-apil/airway_intubation_model/stl_files/mandible_and_tongue_casting/pathological_anatomy_mold/mandible_mold_bottom_tumor.stl

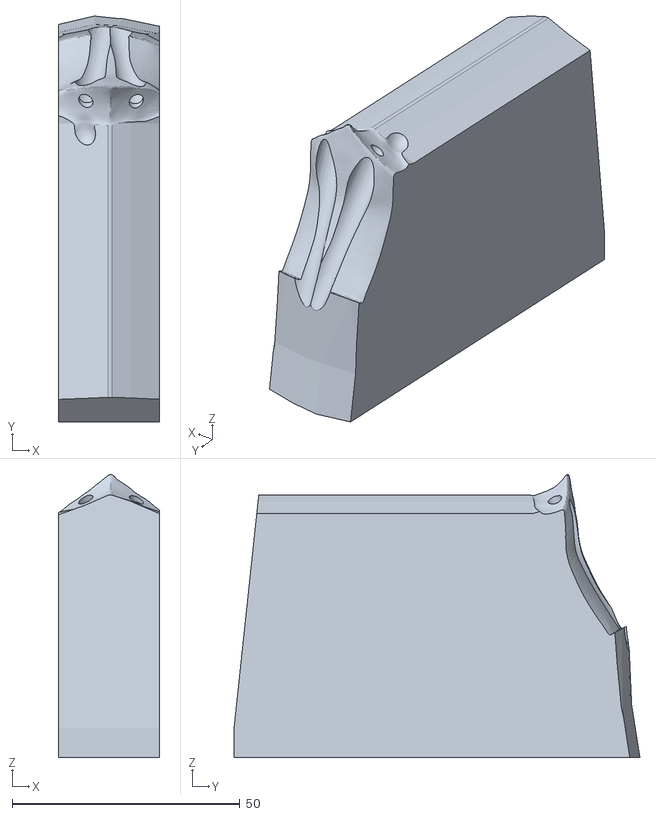
[picture p55: CAD file, 2026-10-06]
stl_files/mandible_and_tongue_casting/pathological_anatomy_mold/mandible_mold_bottom_tumor.stl
22.1 x 89.2 x 62.2
