tgh-apil/airway_intubation_model/stl_files/pharynx_casting/pharynx_mold/connector plates/pharynx_mold_connector_R.stl

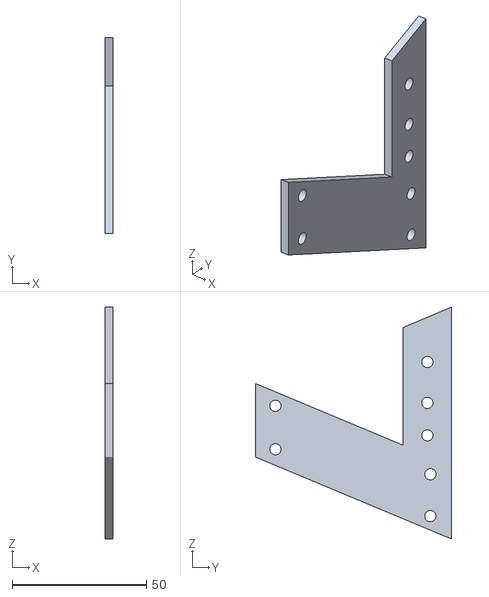
[picture p56: CAD file, 2026-09-28]
stl_files/pharynx_casting/pharynx_mold/connector plates/pharynx_mold_connector_R.stl
3.00 x 73.1 x 86.4
