tgh-apil/airway_intubation_model/stl_files/pharynx_casting/pharynx_mold/pharynx_mold_esophagus_L.stl

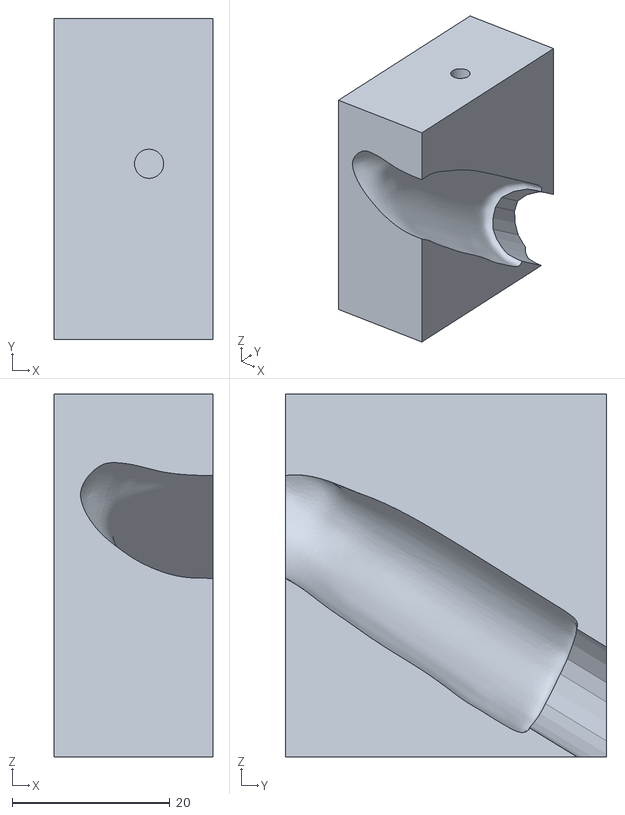
[picture p57: CAD file, 2026-09-28]
stl_files/pharynx_casting/pharynx_mold/pharynx_mold_esophagus_L.stl
20.1 x 40.7 x 46.0
