tgh-apil/airway_intubation_model/stl_files/skin_casting/skin_forehead_bar.stl

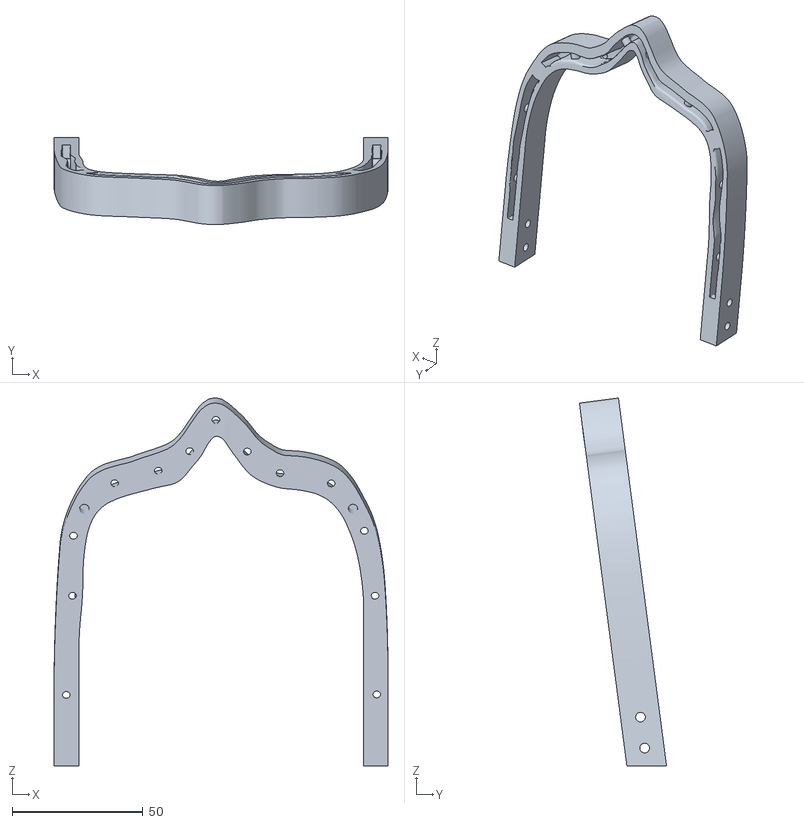
[picture p58: CAD file, 2026-09-29]
stl_files/skin_casting/skin_forehead_bar.stl
127.7 x 33.3 x 140.8
