tgh-apil/airway_intubation_model/stl_files/skin_casting/skin_mold/skin_mold_outer_R.stl

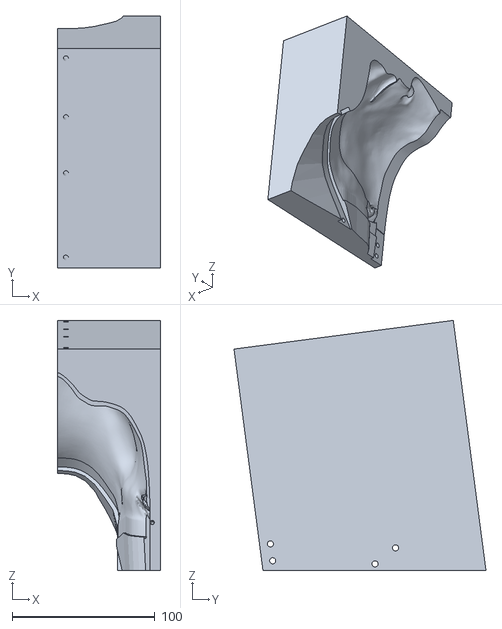
[picture p59: CAD file, 2026-09-29]
stl_files/skin_casting/skin_mold/skin_mold_outer_R.stl
72.5 x 176.8 x 175.6
