tgh-apil/airway_intubation_model/stl_files/thyroid_cartilage_and_connector/thyroid_connector_top.stl

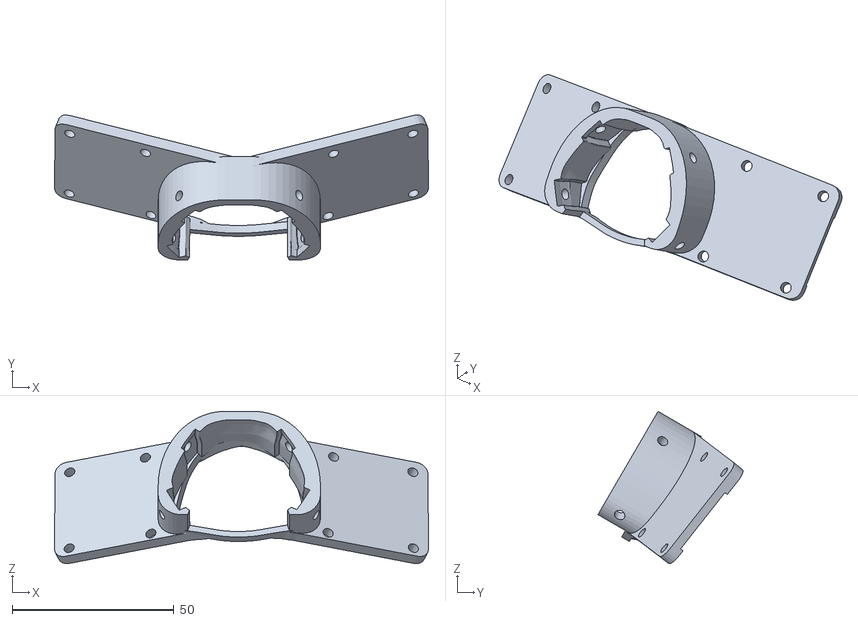
[picture p60: CAD file, 2026-10-07]
stl_files/thyroid_cartilage_and_connector/thyroid_connector_top.stl
115.7 x 44.9 x 47.1
