tgh-apil/airway_intubation_model/stl_files/trachea/pathological/trach_tumor_holder_1.stl

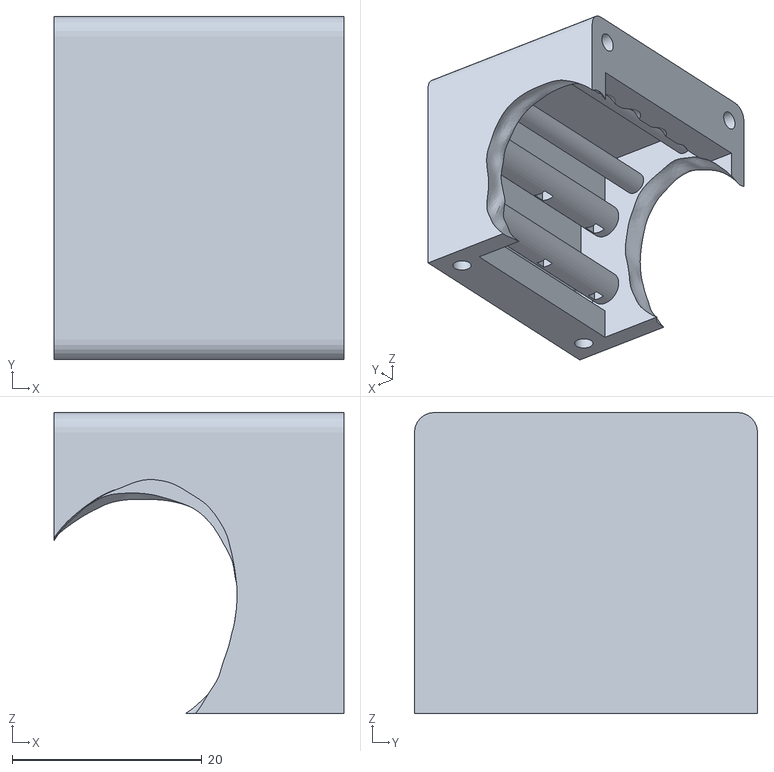
[picture p61: CAD file, 2026-09-21]
stl_files/trachea/pathological/trach_tumor_holder_1.stl
30.6 x 36.2 x 31.7
