tgh-apil/airway_intubation_model/stl_files/vocal_folds/healthy_anatomy/vocal_fold_mold_bottom.stl

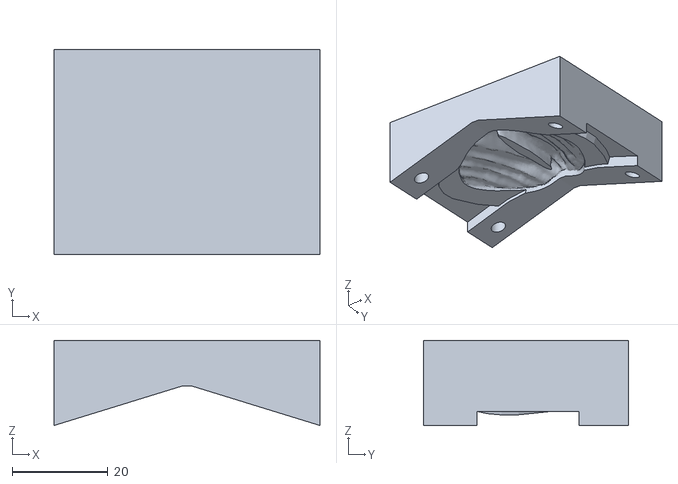
[picture p62: CAD file, 2026-10-12]
stl_files/vocal_folds/healthy_anatomy/vocal_fold_mold_bottom.stl
55.5 x 42.8 x 17.7
