tgh-apil/airway_intubation_model/stl_files/base/intubation_base_cover.stl

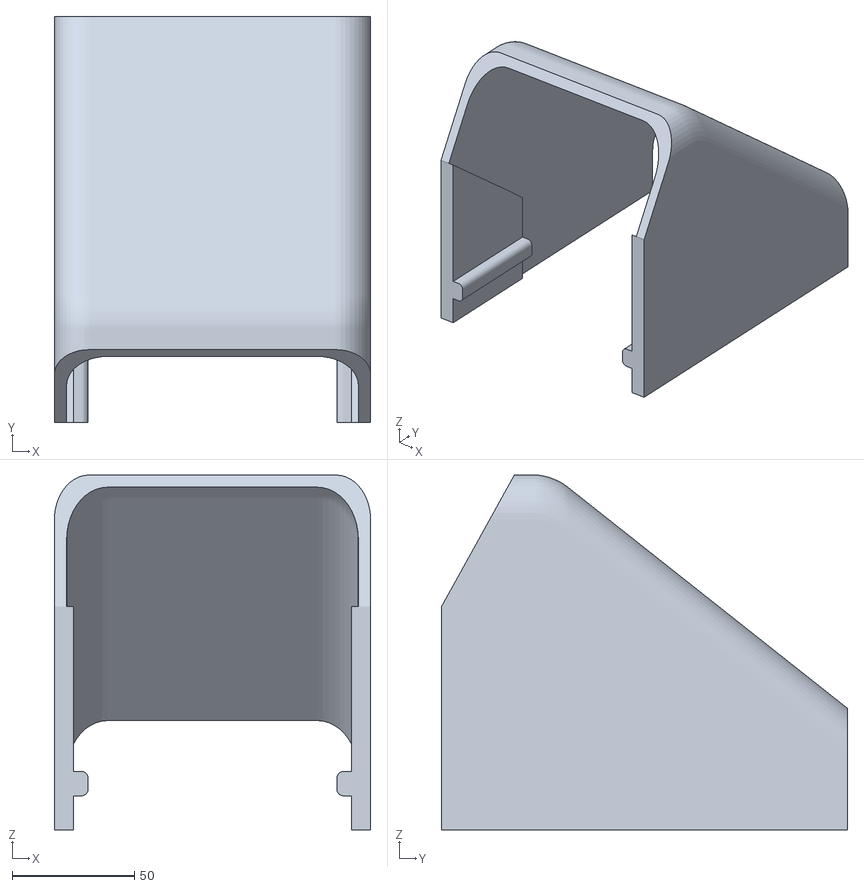
[picture p63: CAD file, 2026-10-07]
stl_files/base/intubation_base_cover.stl
129.6 x 166.4 x 145.5
