tgh-apil/airway_intubation_model/stl_files/mandible_and_tongue_casting/healthy_anatomy_mold/mandible_mold_bottom_plug.stl

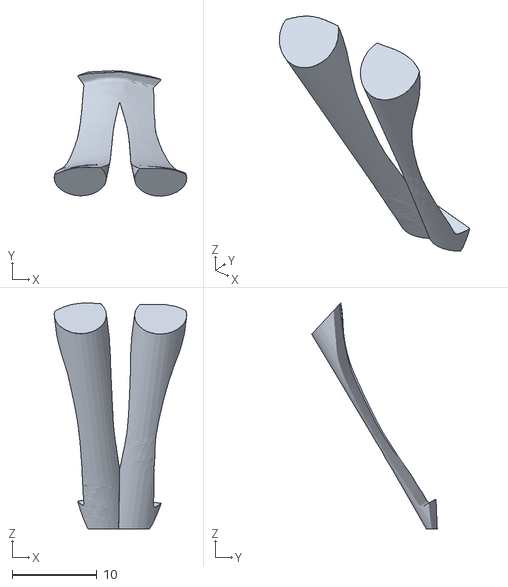
[picture p64: CAD file, 2026-10-06]
stl_files/mandible_and_tongue_casting/healthy_anatomy_mold/mandible_mold_bottom_plug.stl
15.7 x 14.8 x 26.7
