tgh-apil/airway_intubation_model/stl_files/mandible_and_tongue_casting/pathological_anatomy_mold/mandible_mold_top_tumor.stl

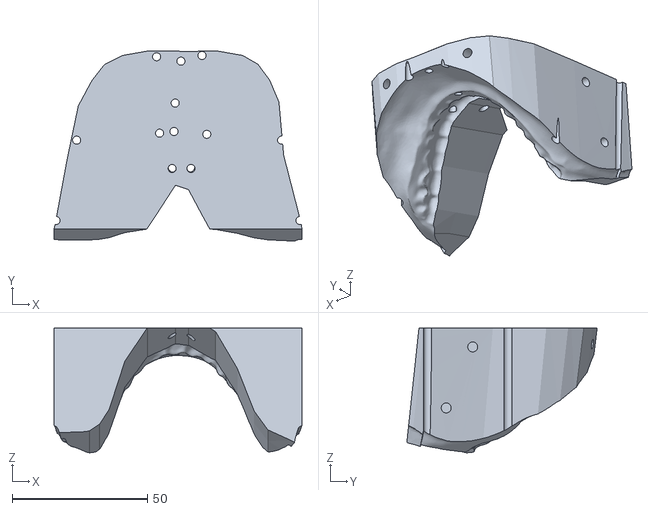
[picture p65: CAD file, 2026-10-06]
stl_files/mandible_and_tongue_casting/pathological_anatomy_mold/mandible_mold_top_tumor.stl
91.6 x 70.3 x 46.1
