tgh-apil/airway_intubation_model/stl_files/pharynx_casting/pharynx_mold/connector plates/pharynx_mold_connector_front.stl

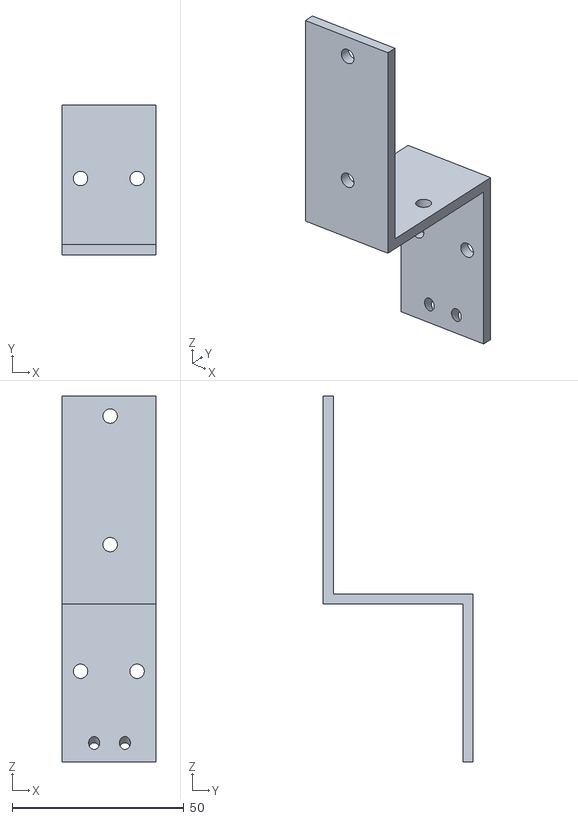
[picture p66: CAD file, 2026-09-28]
stl_files/pharynx_casting/pharynx_mold/connector plates/pharynx_mold_connector_front.stl
27.4 x 43.7 x 106.6
