tgh-apil/airway_intubation_model/stl_files/pharynx_casting/pharynx_mold/pharynx_mold_back_lower_R.stl

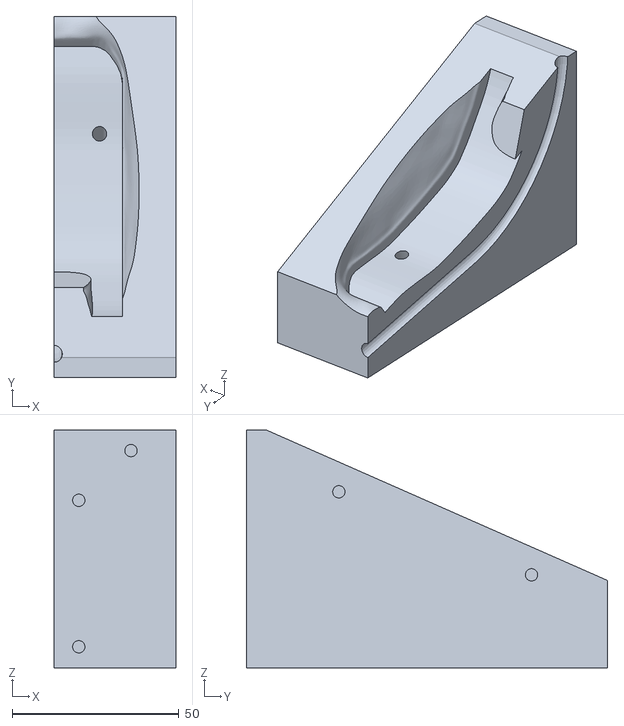
[picture p67: CAD file, 2026-09-28]
stl_files/pharynx_casting/pharynx_mold/pharynx_mold_back_lower_R.stl
36.5 x 108.1 x 71.2
