tgh-apil/airway_intubation_model/stl_files/skin_casting/skin_mold/skin_mold_outer_L.stl

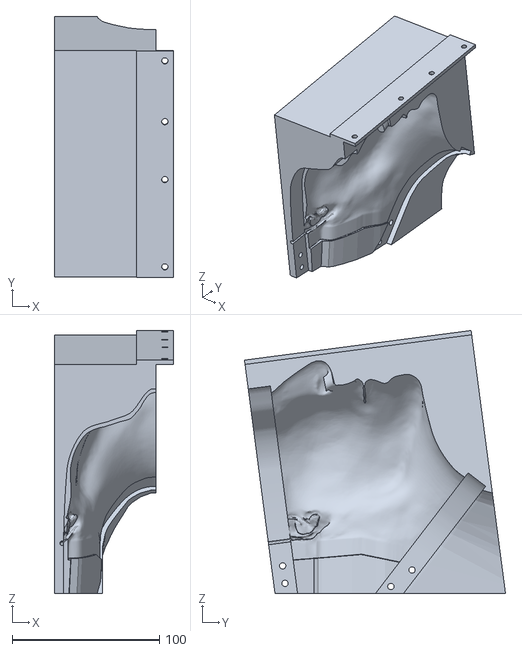
[picture p68: CAD file, 2026-09-29]
stl_files/skin_casting/skin_mold/skin_mold_outer_L.stl
81.0 x 177.2 x 178.5
