tgh-apil/airway_intubation_model/stl_files/thyroid_cartilage_and_connector/thyroid_connector_bottom_R.stl

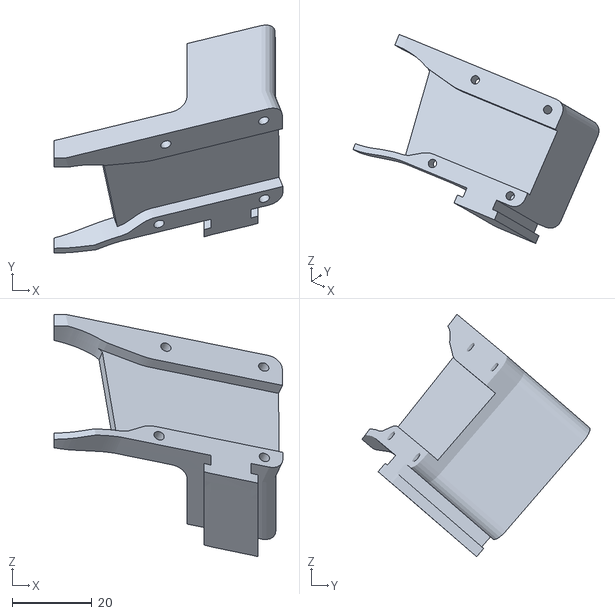
[picture p69: CAD file, 2026-10-07]
stl_files/thyroid_cartilage_and_connector/thyroid_connector_bottom_R.stl
57.4 x 57.2 x 60.7
