tgh-apil/airway_intubation_model/stl_files/trachea/pathological/trachea_tumor.stl

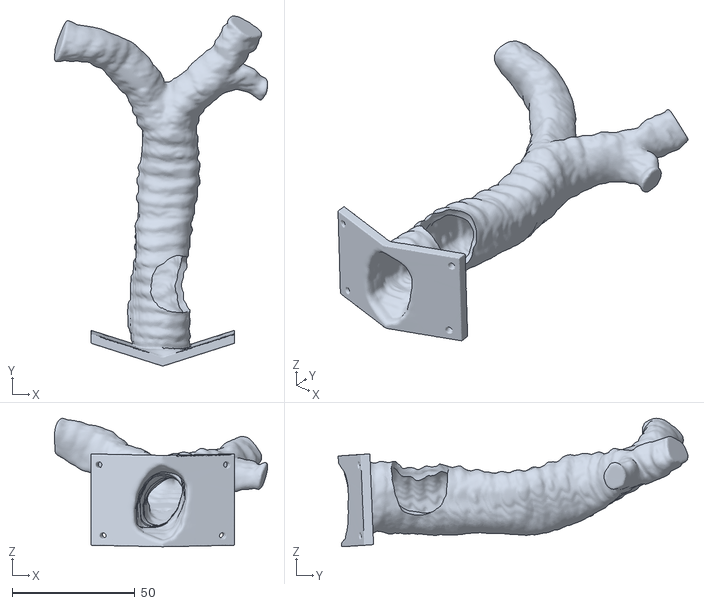
[picture p70: CAD file, 2026-09-21]
stl_files/trachea/pathological/trachea_tumor.stl
86.9 x 142.7 x 52.4
