tgh-apil/airway_intubation_model/stl_files/vocal_folds/pathological_anatomy/thyroid_connector_bottom_R_tumor.stl

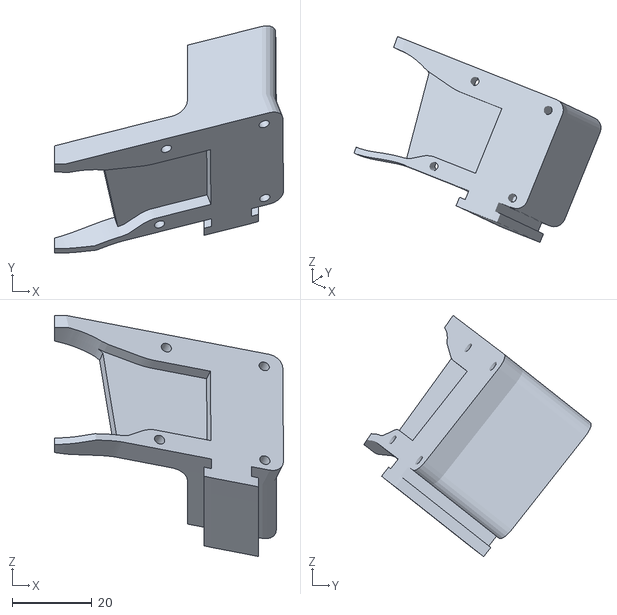
[picture p71: CAD file, 2026-10-12]
stl_files/vocal_folds/pathological_anatomy/thyroid_connector_bottom_R_tumor.stl
57.4 x 57.0 x 60.5
