tgh-apil/airway_intubation_model/stl_files/mandible_and_tongue_casting/pathological_anatomy_mold/mandible_mold_side_R_tumor.stl

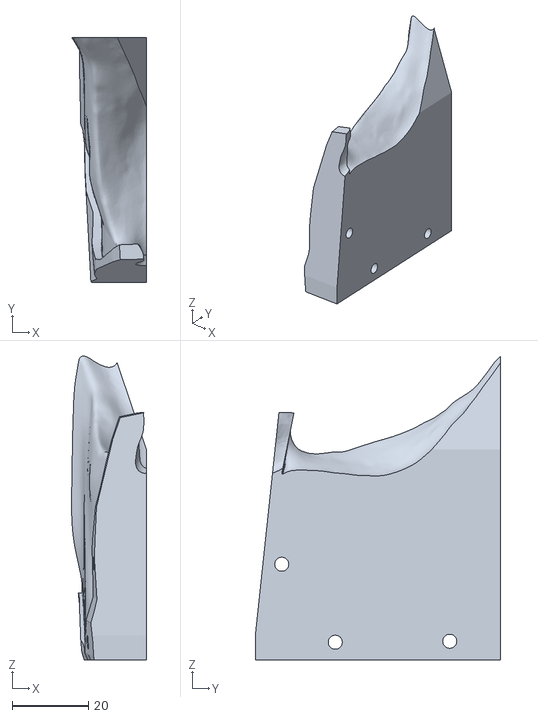
[picture p72: CAD file, 2026-10-06]
stl_files/mandible_and_tongue_casting/pathological_anatomy_mold/mandible_mold_side_R_tumor.stl
19.7 x 64.5 x 80.0
