tgh-apil/airway_intubation_model/stl_files/pharynx_casting/pharynx_mold/connector plates/pharynx_mold_connector_back_upper.stl

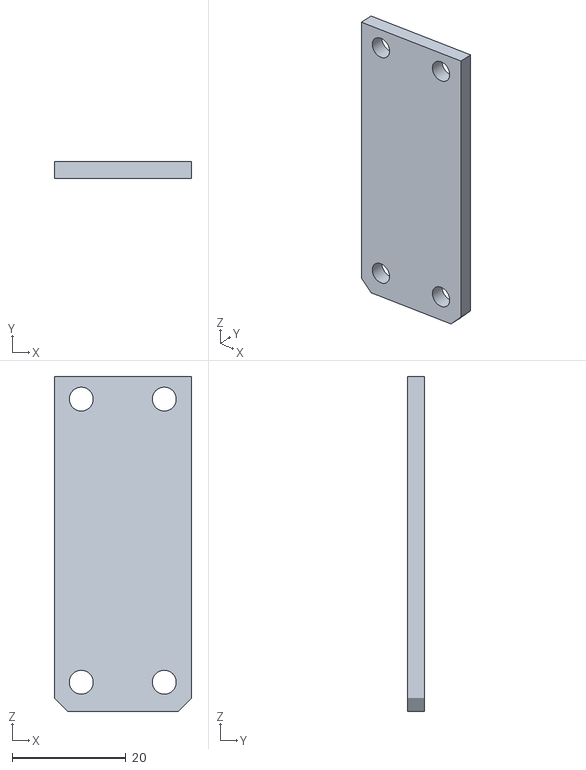
[picture p73: CAD file, 2026-09-28]
stl_files/pharynx_casting/pharynx_mold/connector plates/pharynx_mold_connector_back_upper.stl
24.1 x 3.00 x 58.8
