tgh-apil/airway_intubation_model/stl_files/pharynx_casting/pharynx_mold/pharynx_mold_back_upper_La.stl

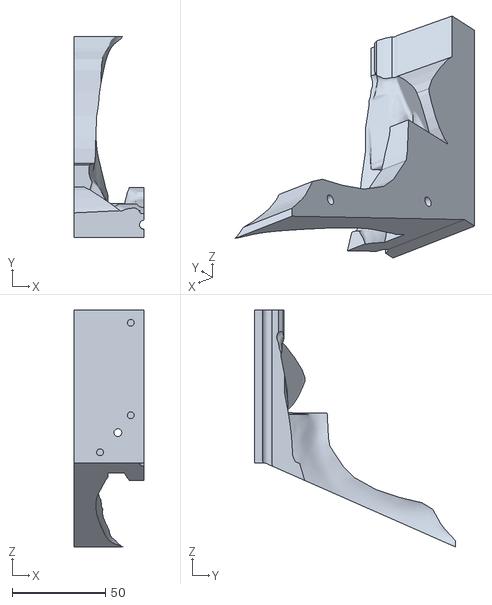
[picture p74: CAD file, 2026-09-28]
stl_files/pharynx_casting/pharynx_mold/pharynx_mold_back_upper_La.stl
37.8 x 108.1 x 127.4
