tgh-apil/airway_intubation_model/stl_files/skin_casting/skin_mold/skin_mold_inner.stl

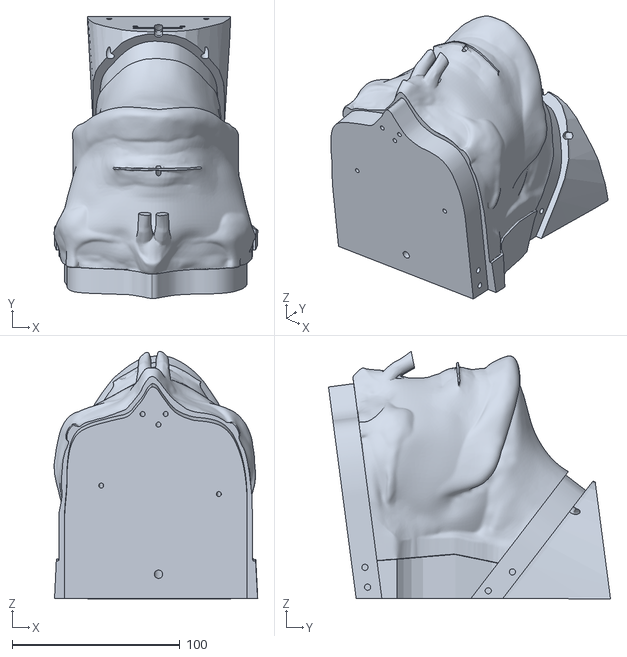
[picture p75: CAD file, 2026-09-29]
stl_files/skin_casting/skin_mold/skin_mold_inner.stl
121.3 x 168.0 x 147.5
