tgh-apil/airway_intubation_model/stl_files/thyroid_cartilage_and_connector/thyroid_cartilege.stl

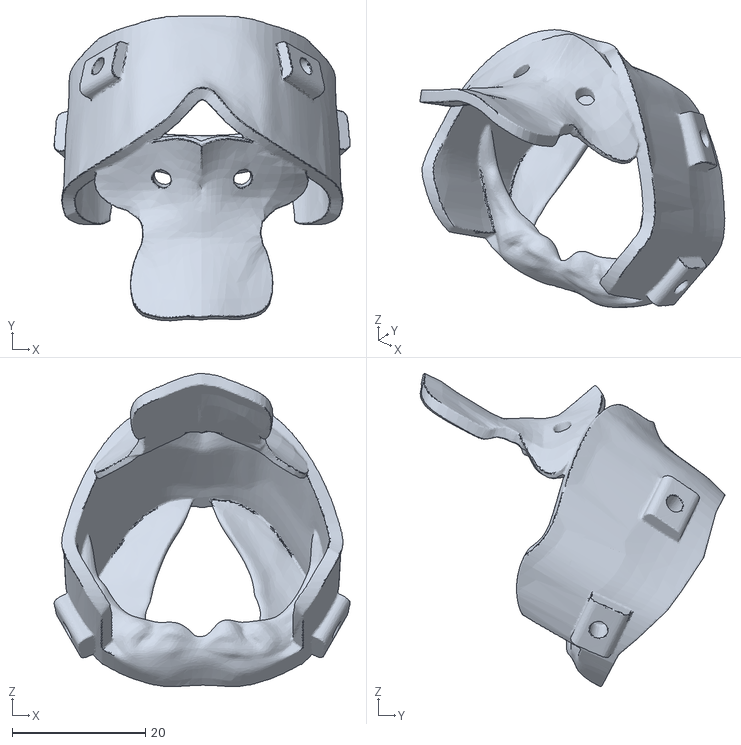
[picture p76: CAD file, 2026-10-07]
stl_files/thyroid_cartilage_and_connector/thyroid_cartilege.stl
44.4 x 45.7 x 46.9
