tgh-apil/airway_intubation_model/stl_files/trachea/pathological/trach_tumor_mold.stl

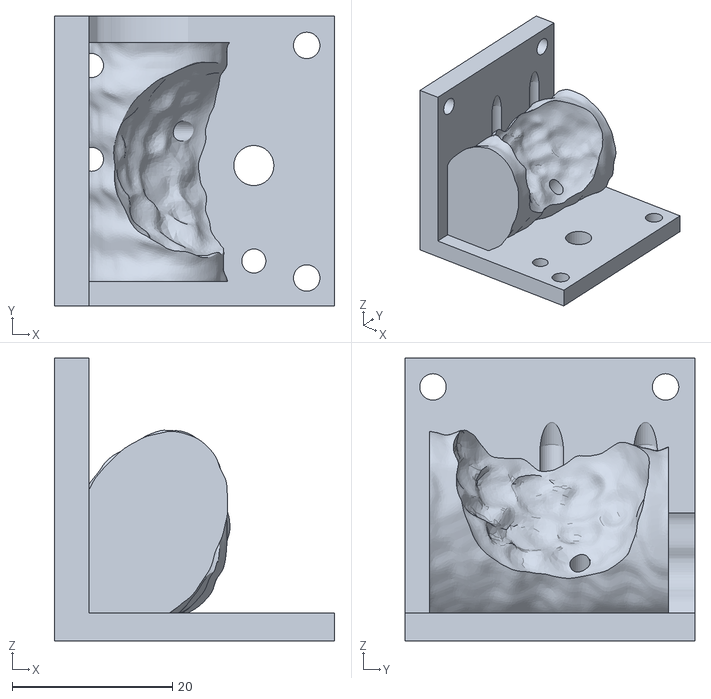
[picture p77: CAD file, 2026-09-21]
stl_files/trachea/pathological/trach_tumor_mold.stl
34.9 x 36.2 x 35.3
