tgh-apil/airway_intubation_model/stl_files/mandible_and_tongue_casting/pathological_anatomy_mold/mandible_mold_back_tumor.stl

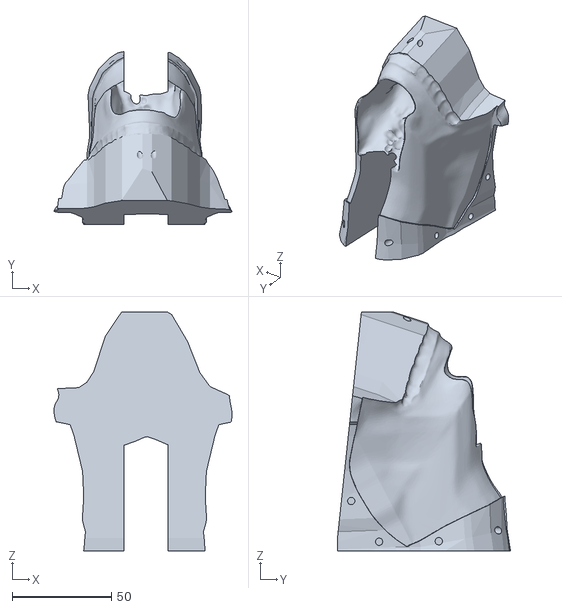
[picture p78: CAD file, 2026-10-06]
stl_files/mandible_and_tongue_casting/pathological_anatomy_mold/mandible_mold_back_tumor.stl
89.8 x 87.4 x 120.6
