tgh-apil/airway_intubation_model/stl_files/pharynx_casting/pharynx_mold/connector plates/pharynx_mold_connector_back.stl

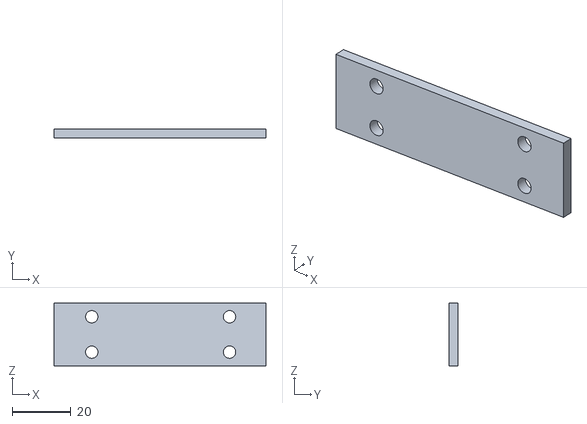
[picture p81: CAD file, 2026-09-28]
stl_files/pharynx_casting/pharynx_mold/connector plates/pharynx_mold_connector_back.stl
71.9 x 3.00 x 21.3
