tgh-apil/airway_intubation_model/stl_files/pharynx_casting/pharynx_mold/pharynx_mold_front_lower.stl

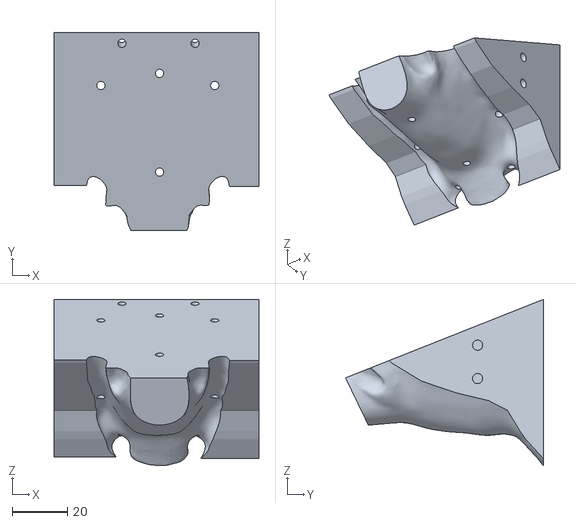
[picture p82: CAD file, 2026-09-28]
stl_files/pharynx_casting/pharynx_mold/pharynx_mold_front_lower.stl
74.3 x 71.7 x 60.2
