tgh-apil/airway_intubation_model/stl_files/pharynx_casting/pharynx_mold/pharynx_mold_esophagus_inner.stl

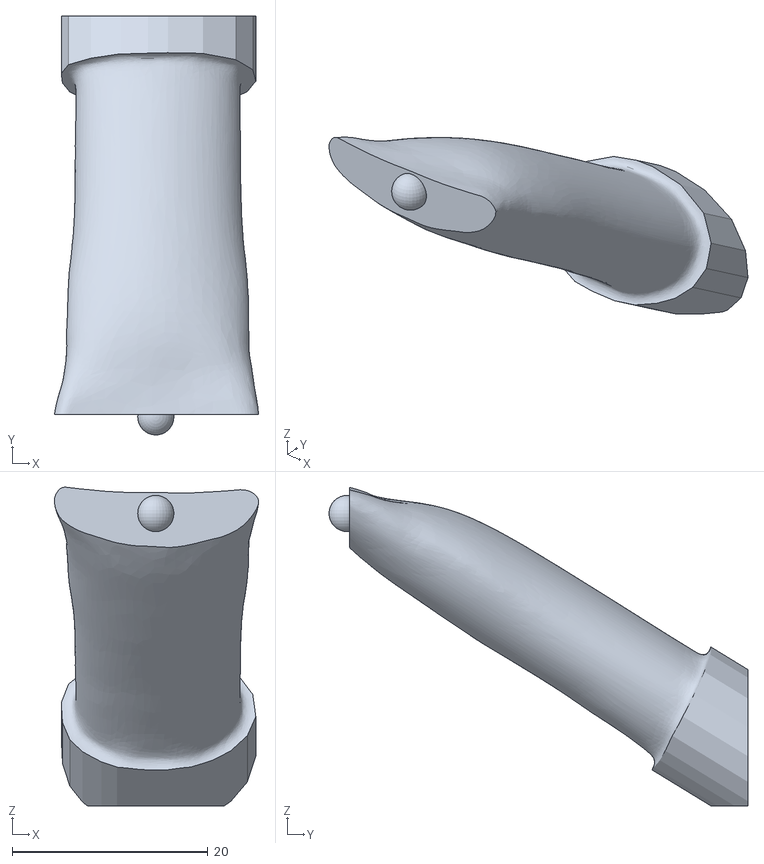
[picture p84: CAD file, 2026-09-28]
stl_files/pharynx_casting/pharynx_mold/pharynx_mold_esophagus_inner.stl
20.9 x 42.8 x 32.5
