tgh-apil/airway_intubation_model/stl_files/pharynx_casting/pharynx_mold/pharynx_mold_back_upper_Rb.stl

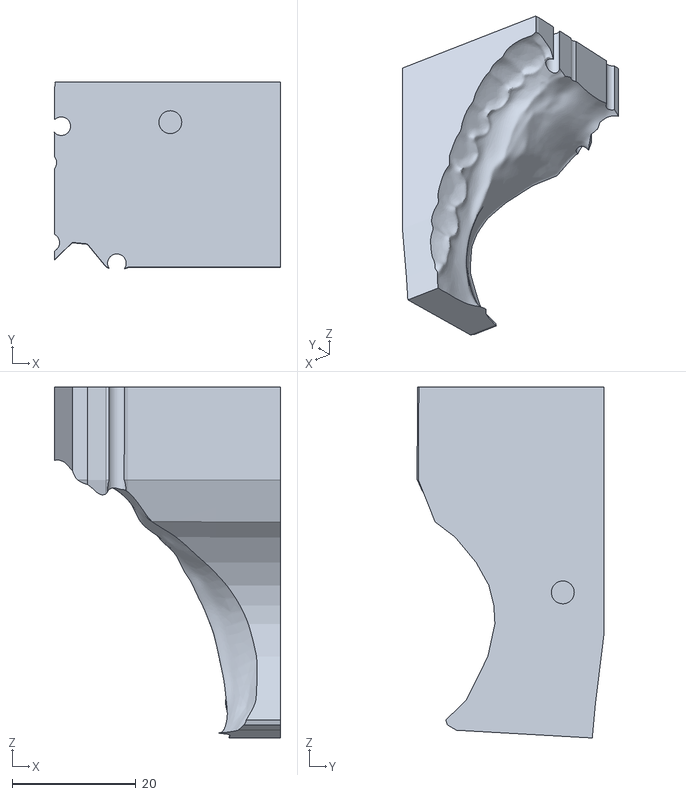
[picture p85: CAD file, 2026-09-28]
stl_files/pharynx_casting/pharynx_mold/pharynx_mold_back_upper_Rb.stl
36.5 x 30.2 x 56.7
