tgh-apil/airway_intubation_model/stl_files/pharynx_casting/pharynx_mold/pharynx_mold_esophagus_R.stl

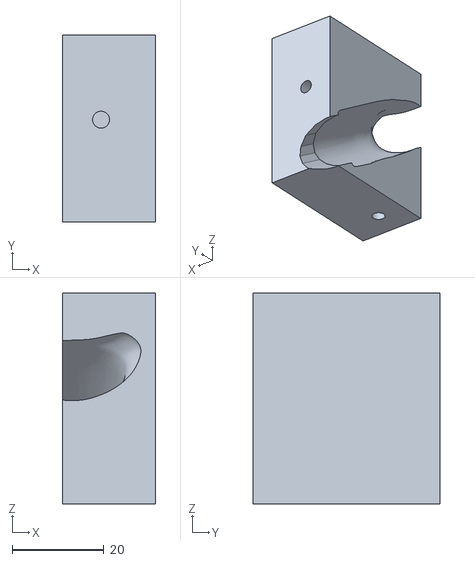
[picture p86: CAD file, 2026-09-28]
stl_files/pharynx_casting/pharynx_mold/pharynx_mold_esophagus_R.stl
20.2 x 40.7 x 46.0
