tgh-apil/airway_intubation_model/stl_files/pharynx_casting/pharynx_mold/pharynx_mold_front_upper.stl

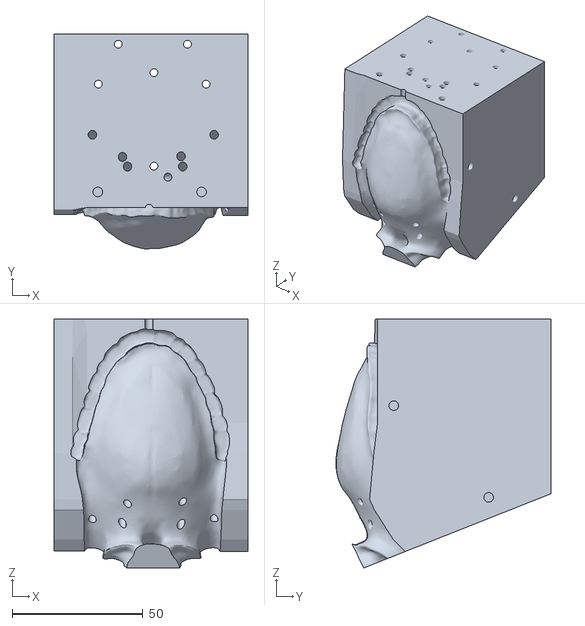
[picture p87: CAD file, 2026-09-28]
stl_files/pharynx_casting/pharynx_mold/pharynx_mold_front_upper.stl
74.3 x 82.3 x 95.4
