tgh-apil/airway_intubation_model/(list of files, cad)

Other CAD files:
stl_files/vocal_folds/pathological_anatomy/vocal_fold_mold_top_tumor.stl
stl_files/vocal_folds/pathological_anatomy/vocal_fold_mold_bottom_tumor.stl
stl_files/vocal_folds/vocal_fold_wing_L.stl
stl_files/mandible_and_tongue_casting/healthy_anatomy_mold/mandible_mold_front_L.stl
stl_files/mandible_and_tongue_casting/healthy_anatomy_mold/mandible_mold_top.stl
stl_files/pharynx_casting/pharynx_mold/connector plates/pharynx_mold_connector_L.stl
stl_files/mandible_and_tongue_casting/healthy_anatomy_mold/mandible_mold_side_R.stl
stl_files/mandible_and_tongue_casting/healthy_anatomy_mold/mandible_mold_front_R.stl
stl_files/mandible_and_tongue_casting/pathological_anatomy_mold/mandible_mold_side_L_tumor.stl
stl_files/mandible_and_tongue_casting/healthy_anatomy_mold/mandible_mold_back.stl
