tgh-apil/airway_intubation_model/(commit log)

2026-09-04 adding photos of model assembly process
2026-09-05 Update README.md
    text instructions for assembly of completed components
2026-09-21 Update README.md
    added mold release agent to casting materials list
2026-09-21 adding trachea stl files
    [trach_tumor_holder_1.stl, trach_tumor_holder_2.stl, trach_tumor_mold.stl, trachea_healthy_v3.stl, trachea_tumor.stl]
2026-09-21 Update README.md
    trachea stl file links
2026-09-21 Update trachea_tumor_casting.md
    links to stl files
2026-10-06 Add files via upload
    adding stl files for casting the mandible and tongue silicone component (healthy and pathological versions)
    [epiglottis_plate.stl, mandible.stl, mandible_mold_back.stl, mandible_mold_back_tumor.stl, mandible_mold_bottom_plug.stl, mandible_mold_bottom_tumor.stl, mandible_mold_front_L.stl, mandible_mold_front_L_tumor.stl]
2026-10-06 Add files via upload
    reuploading folder with correct healthy bottom mold component
    [mandible_mold_bottom.stl]
2026-10-07 Add files via upload
    uploading base and skull files
    [intubation_base.stl, intubation_base_cover.stl, skull.stl]
2026-10-07 Add files via upload
    adding nasal passage and thyroid files
    [nasal_passage.stl, thyroid_cartilege.stl, thyroid_connector_bottom_L.stl, thyroid_connector_bottom_R.stl, thyroid_connector_top.stl]
2026-10-07 Update README.md
    linking more stl files
